brendan779/ipad-pro-wall-mount/flush-v5.1/CUTOUT_TEMPLATE_A3.pdf

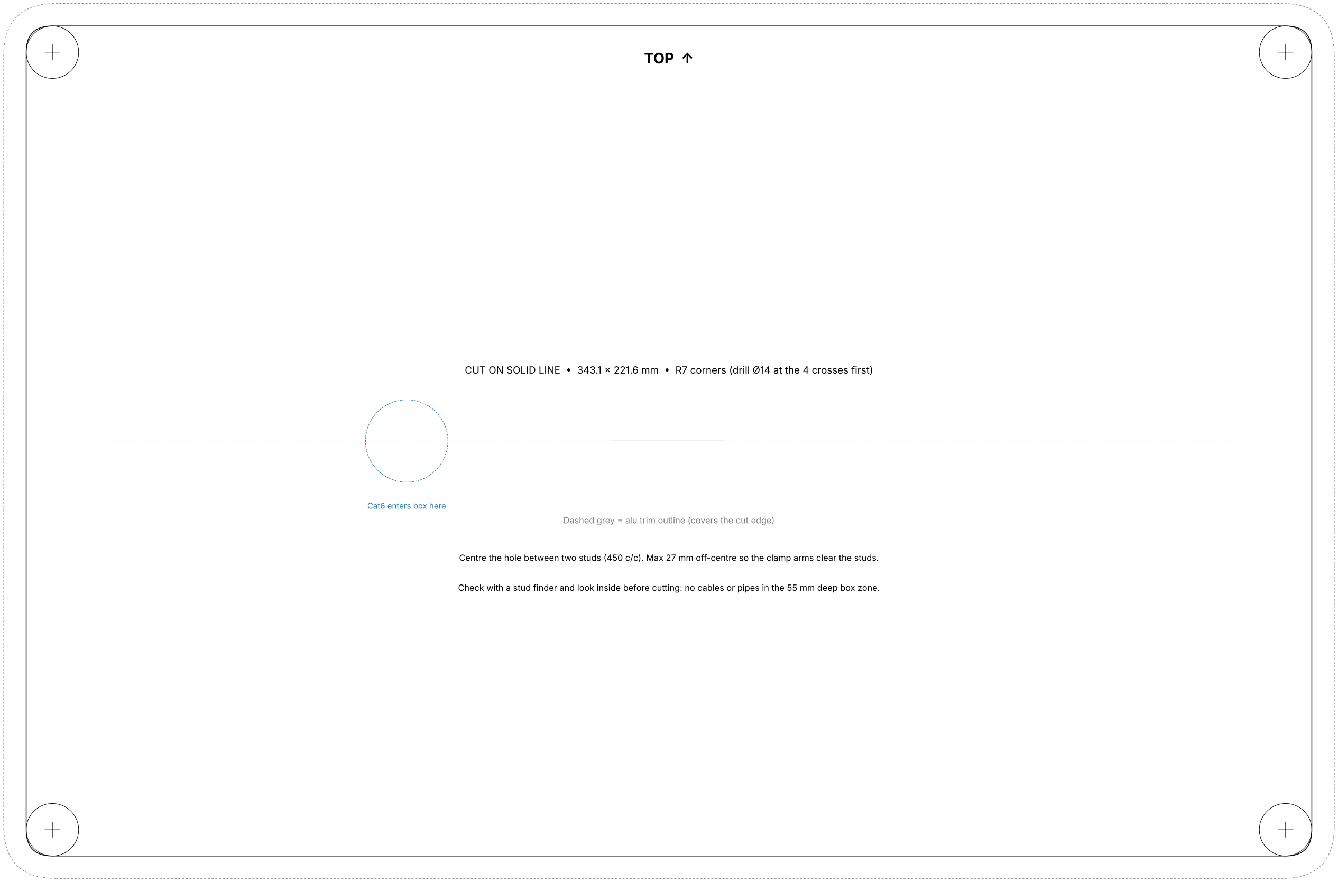
[picture p4: figure]
Cat6 enters box here; TOP ↑

CUT ON SOLID LINE • 343.1 × 221.6 mm • R7 corners (drill Ø14 at the 4 crosses first)

Dashed grey = alu trim outline (covers the cut edge)

Centre the hole between two studs (450 c/c). Max 27 mm off-centre so the clamp arms clear the studs.

Check with a stud finder and look inside before cutting: no cables or pipes in the 55 mm deep box zone.

Print at 100% / Actual size on A3. This bar must measure exactly 100 mm.

iPad Pro 12.9 Flush Mount v5 • plasterboard cut-out template
