brendan779/ipad-pro-wall-mount/ipad_mini_a17_pro/flush/machined/CUTOUT_TEMPLATE_A3.pdf

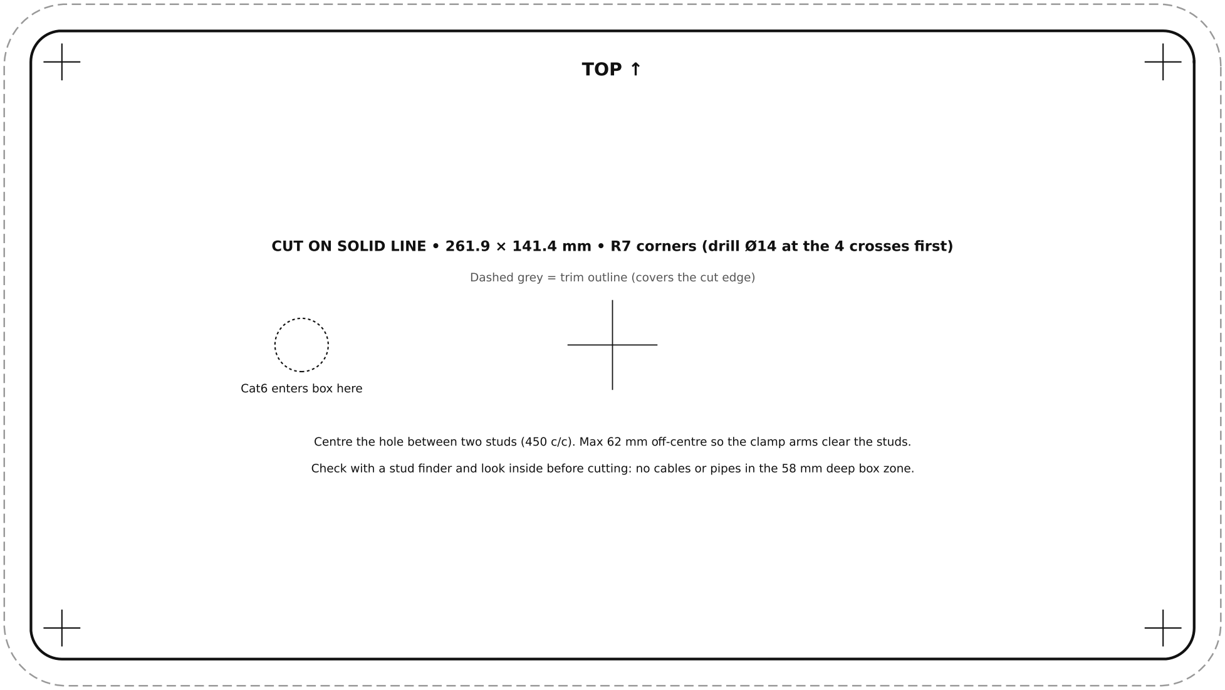
[picture p5: figure]
Cat6 enters box here; TOP ↑

## CUT ON SOLID LINE • 261.9 × 141.4 mm • R7 corners (drill Ø14 at the 4 crosses first)

Dashed grey = trim outline (covers the cut edge)

Centre the hole between two studs (450 c/c). Max 62 mm off-centre so the clamp arms clear the studs.

Check with a stud finder and look inside before cutting: no cables or pipes in the 58 mm deep box zone.

## iPad mini (A17 Pro) Flush Mount v6 • plasterboard cut-out template

Print at 100% / Actual size on A3. This bar must measure exactly 100 mm.
