brendan779/ipad-pro-wall-mount/ipad_pro_11_m5/flush/machined/CUTOUT_TEMPLATE_A3.pdf

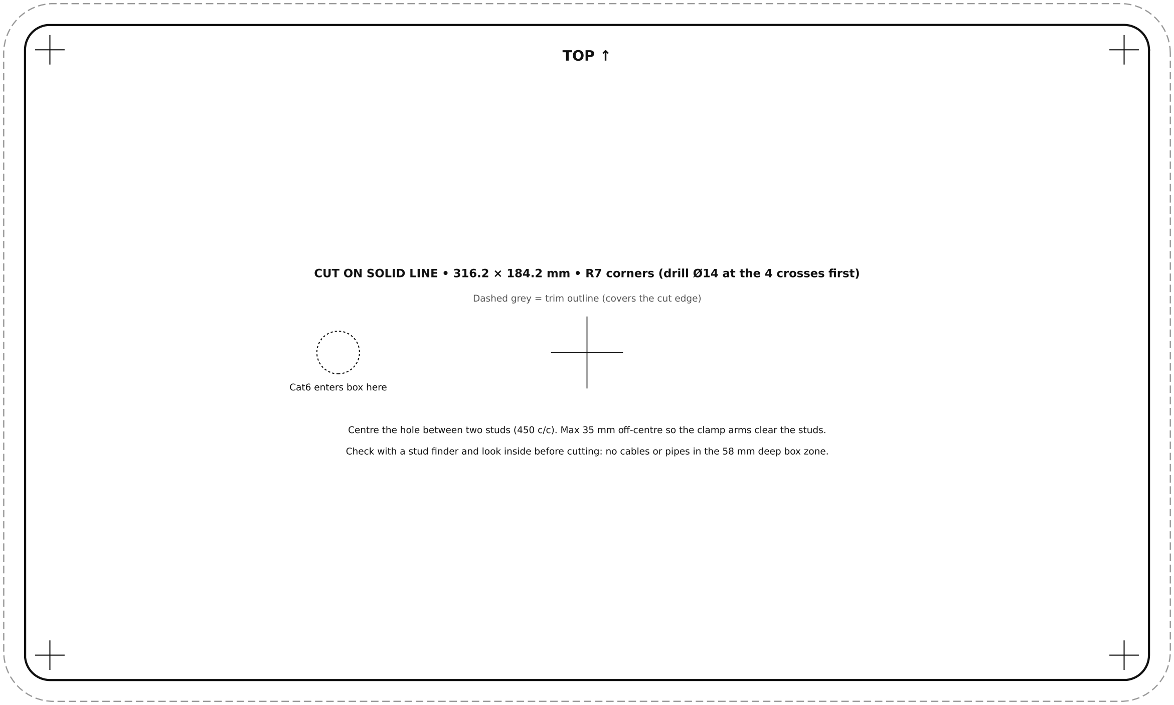
[picture p6: figure]
Cat6 enters box here; TOP ↑

# CUT ON SOLID LINE • 316.2 × 184.2 mm • R7 corners (drill Ø14 at the 4 crosses first)

Dashed grey = trim outline (covers the cut edge)

Centre the hole between two studs (450 c/c). Max 35 mm off-centre so the clamp arms clear the studs.

Check with a stud finder and look inside before cutting: no cables or pipes in the 58 mm deep box zone.

# iPad Pro 11″ (M5) Flush Mount v6 • plasterboard cut-out template

Print at 100% / Actual size on A3. This bar must measure exactly 100 mm.
