brendan779/ipad-pro-wall-mount/previous-releases/README.md

# Previous releases: Float v4.1 / v4.2, Flush v5.1

> **These versions are superseded by [v6](../)**, which builds both mounts for the iPad Pro 12.9″ (3rd gen), iPad Pro 13″ and 11″ (M5) and iPad mini (A17 Pro). v6 fixes the 12.9″'s pressed volume buttons, adds 2 mm more room at each end for the USB-C cable loop, adds end stops to the Float's wall rail, and models every piece of hardware in the STEP files. Start a new build from [the v6 README](../README.md).
>
> Everything below is kept unchanged for reference and for panels already built.

A premium wall mount that turns an **iPad Pro 12.9″ (3rd gen: A1876, A1895, A2014, A1983)** into a permanently powered HomeKit / Home Assistant panel over a single Cat6 cable (PoE+). It has a machined 6061 aluminium face and 3D-printed hidden parts, with the cable fully concealed.

There are two versions:

| | [**Float v4.1**](float-v4.1/) (surface mount) | [**Flush v5.1**](flush-v5.1/) (in-wall) |
|---|---|---|
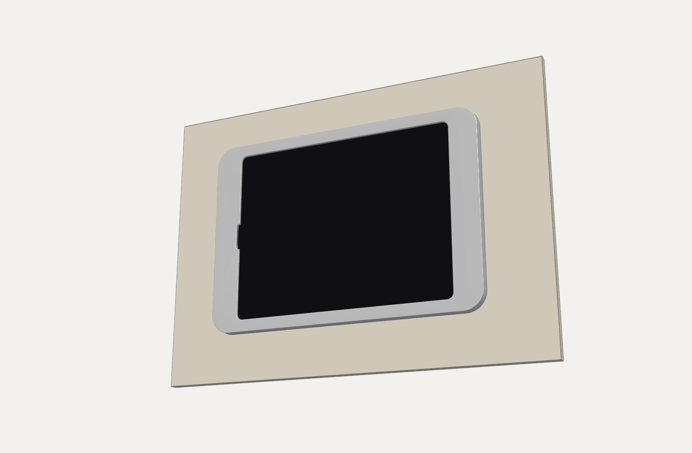
[picture p7: previous-releases/float-v4.1/images/hero.png]
Float v4.1
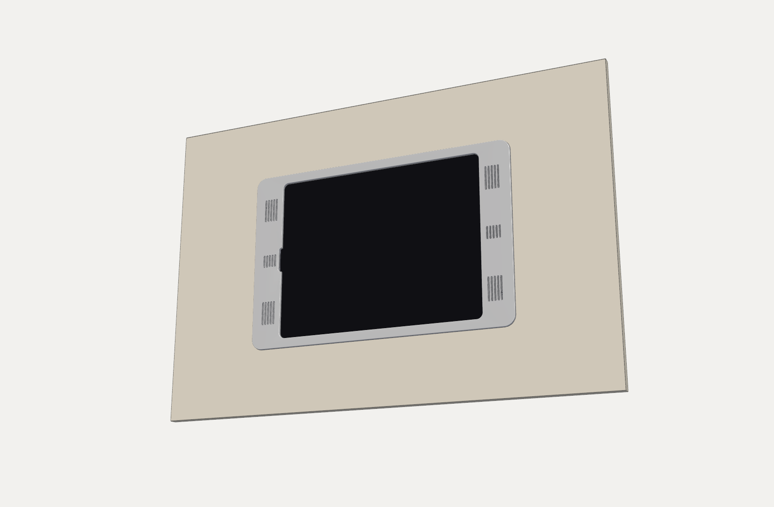
[picture p8: previous-releases/flush-v5.1/images/hero.png]
Flush v5.1
| |  |  |
| Look | Floats 14 mm off the wall on a shadow gap | Glass 1.2 mm off the wall, trim 4.5 mm proud |
| Aluminium part | 344.1 × 238.9 × 11.7 mm shell, about 223 g | 355.1 × 233.6 × 3 mm trim, about 188 g |
| Wall work | One small cut-out behind the panel for the cable | 343.1 × 221.6 mm cut-out between studs (10 mm plasterboard, 70 mm studs at 450 c/c) |
| Fixing | Bracket + hook + one hidden M3 lock screw | 4 dog-ear arms clamp the plasterboard; magnetic trim |
| Build manual (PDF) | [Float_Mount_v4.1_Build_Manual.pdf](float-v4.1/Float_Mount_v4.1_Build_Manual.pdf) | [Float_Mount_v5.1_Flush_Build_Manual.pdf](flush-v5.1/Float_Mount_v5.1_Flush_Build_Manual.pdf) |
| Build manual (web) | [BUILD_MANUAL.md](float-v4.1/BUILD_MANUAL.md) | [BUILD_MANUAL.md](flush-v5.1/BUILD_MANUAL.md) |

**Ordering the Float shell from a CNC service?** Use [**Float v4.2**](float-v4.2/) and its [build manual](float-v4.2/Float_Mount_v4.2_Build_Manual.pdf). It is v4.1 plus a JLCCNC-ready manufacturing drawing (threaded holes M3/M2.5, hole table, section), drill-point-safe hole depths with M3 × 5 / M2.5 × 5 screws, and one-piece versions of the split printed parts for large-bed printers.

**No CNC?** Both mounts also come in a [**fully printed**](fully-printed/) version. The aluminium face becomes a two-piece printed face joined with dovetails, and each version has a ready-to-slice Bambu Studio 3MF (also suitable for MakerWorld).

Both versions use a **standard straight USB-C cable** (the plug and its bend hide inside the frame ends), a PoE+ to USB-C adapter (e.g. PoE Texas / Heckler T515), and print with **no supports** on a 256 mm bed (Bambu P1S / X1C class) in PETG or ASA.

## Repository layout

```
float-v4.1/                 surface-mount version
  README.md                 build notes: parts, machining, hardware, assembly
  Float_Mount_v4.1_Build_Manual.pdf  build manual, one step per page
  BUILD_MANUAL.md           the same manual as a GitHub page
  hybrid.py                 parametric CadQuery source (regenerates every file)
  overhang_audit.py         checks each part for unsupported overhangs
  assembly_hybrid_v4_1.step whole stack
  machine/shell_6061.step   the aluminium part, for CAM
  print/                    STL + STEP for every printed part
  images/                   manual renders and schematics

float-v4.2/                 v4.1 + CNC drawing for the shell, drill-safe threads, one-piece printed parts
  Float_Mount_v4.2_Build_Manual.pdf  build manual (v4.2 changes, JLCCNC ordering, printed-shell option)
  machine/shell_6061_drawing.pdf   A3 drawing to send with shell_6061.step
  print/one_piece/          uncut carrier (340 mm beds)

flush-v5.1/                 flush in-wall version
  README.md, Float_Mount_v5.1_Flush_Build_Manual.pdf, BUILD_MANUAL.md, flush51.py
  CUTOUT_TEMPLATE_A3.pdf    print at 100% on A3 (100 mm check bar)
  assembly_flush_v5_1.step, machine/trim_6061.step, print/, images/

fully-printed/              no-machining versions: printed face halves + Bambu Studio 3MF projects
  float-v4.1-printed/       Float_Mount_v4.1_Printed.3mf, print/
  float-v4.2-printed/       Float_Mount_v4.2_Printed.3mf, print/, print/one_piece/ (uncut shell + carrier)
  flush-v5.1-printed/       Float_Mount_v5.1_Flush_Printed.3mf, print/
  printed.py, printed42.py, make3mf.py   regenerate the printed faces and the 3MFs

../tools/manual/            scripts that render the manual images (VTK + matplotlib)
```

## Customising

Every dimension comes from the parameters at the top of `hybrid.py` / `flush51.py`. Measure your USB-C plug (`PLUG_L`, `PLUG_W`, `PLUG_H`), cable (`CABLE_D`, `BEND_R`) or wall (`PLASTER`), change the numbers and re-run:

```bash
pip install cadquery
cd float-v4.1 && python hybrid.py out      # writes print/, machine/ and STEP files to ./out
cd flush-v5.1 && python flush51.py out
```

To regenerate the manual images: `cd ../tools/manual && python render_v41.py && python render_v51.py && python schematics.py && python sections.py` (needs `vtk`, `matplotlib`). Run `sections.py` last; it draws the final cross-sections.

## Notes

- Button, camera, speaker and microphone positions on the iPad are close approximations. Print a test fit (v4.1 includes a printable copy of the aluminium shell) before you machine metal or cut a wall.
- The physical buttons end up covered. Use AssistiveTouch, Siri or Settings › Shut Down.
- The build manuals follow the style of the free [Flightory](https://flightory.com) RC plane manuals.

## Licence

[GPL-3.0](../LICENSE)
