brendan779/ipad-pro-wall-mount/float-v4.2/images/mach_bosses.png

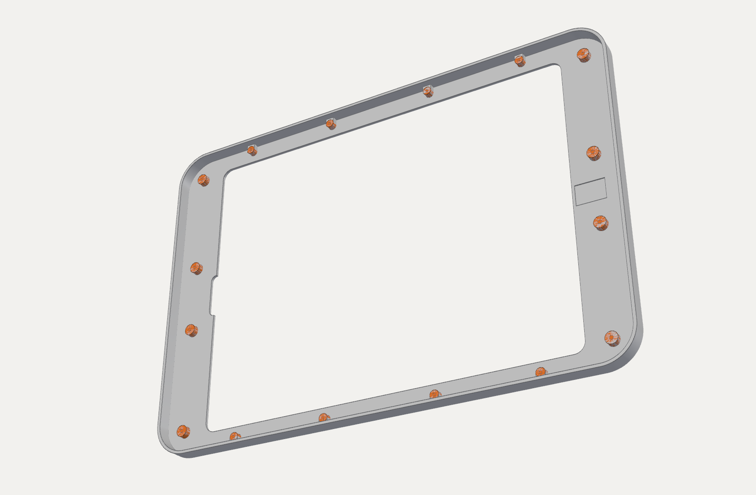
float-v4.2/images/mach_bosses.png
