brendan779/ipad-pro-wall-mount/float-v4.2/images/w4_hang.png

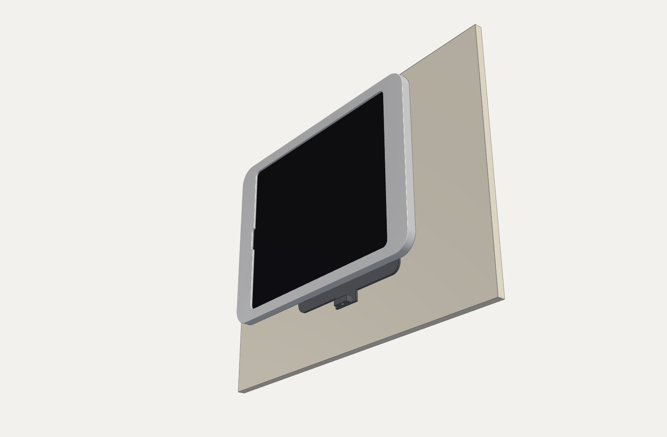
float-v4.2/images/w4_hang.png
