brendan779/ipad-pro-wall-mount/ipad_mini_a17_pro/float/machined/machine/shell_6061_drawing.png

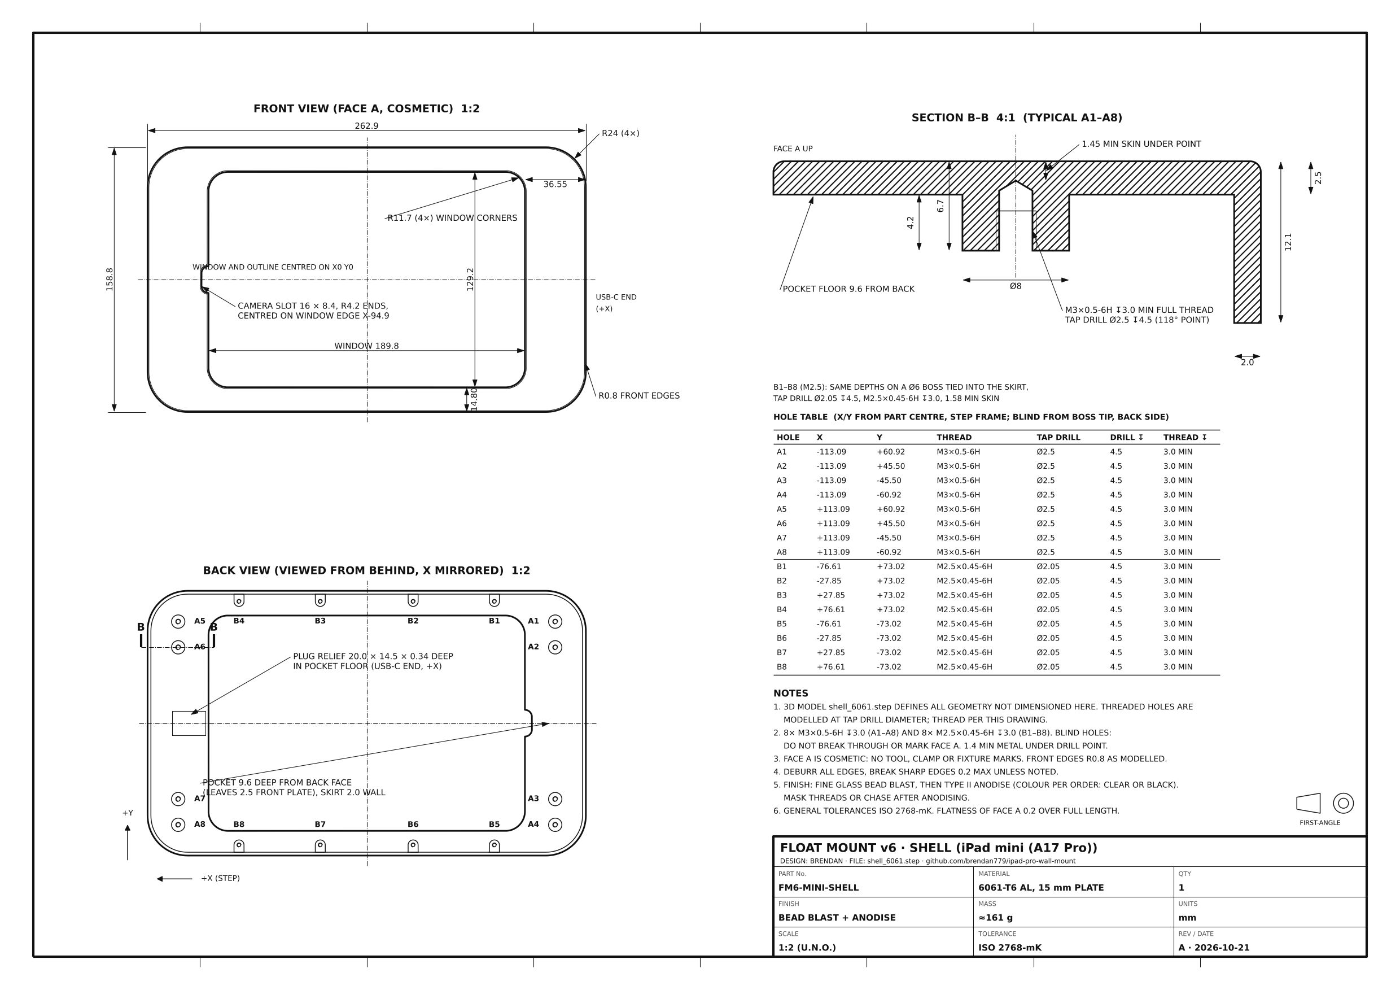
ipad_mini_a17_pro/float/machined/machine/shell_6061_drawing.png
