brendan779/ipad-pro-wall-mount/ipad_pro_13_m5/float/machined/machine/shell_6061_drawing.png

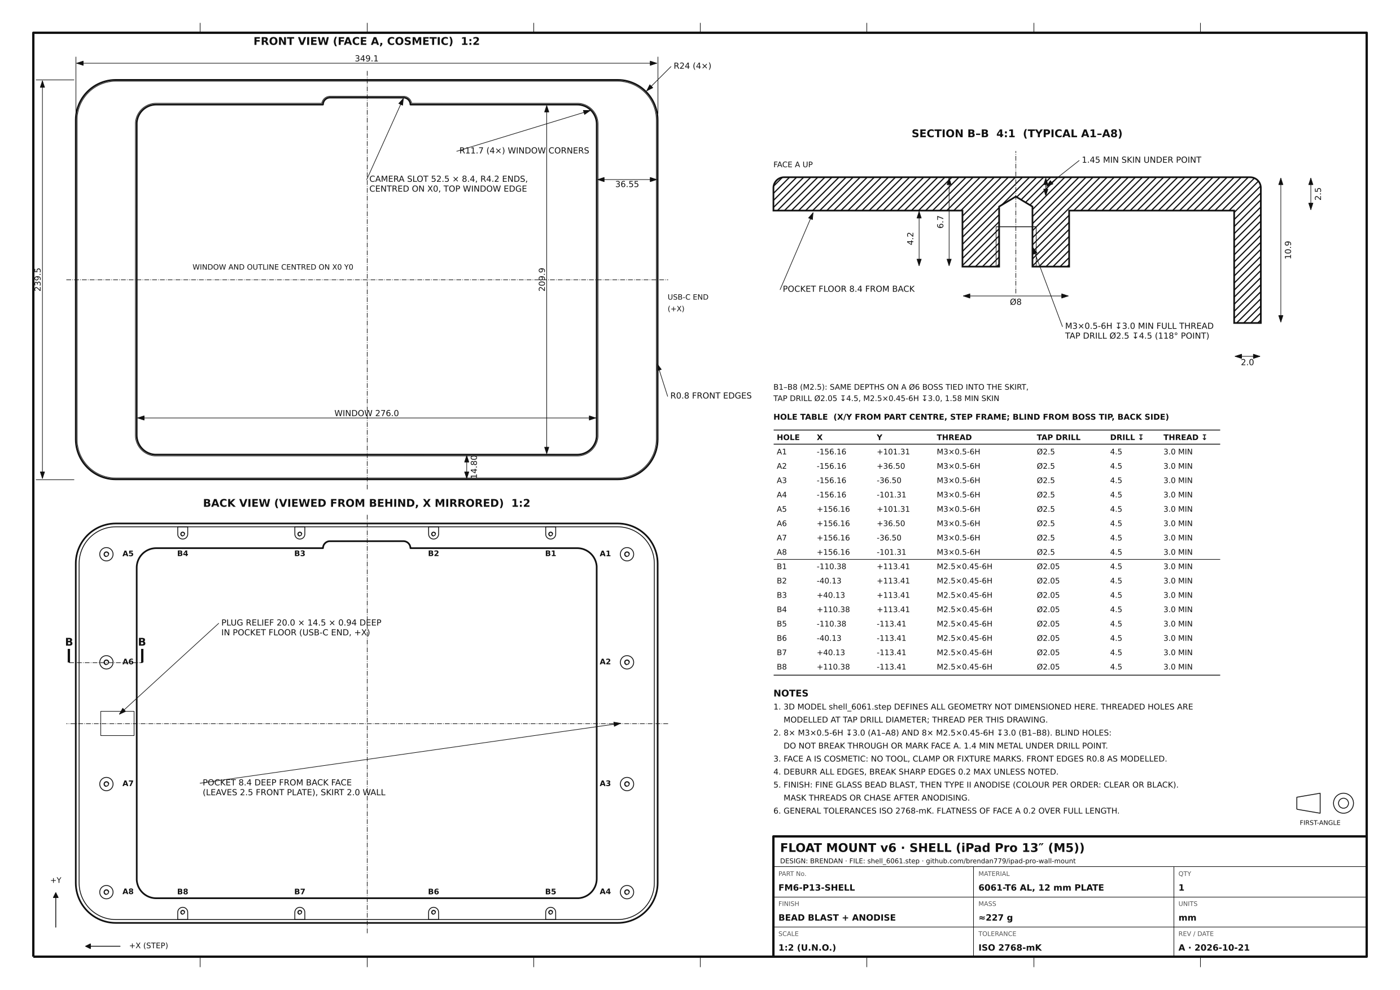
ipad_pro_13_m5/float/machined/machine/shell_6061_drawing.png
