brendan779/ipad-pro-wall-mount/float-v4.2/assembly_hybrid_v4_2.step

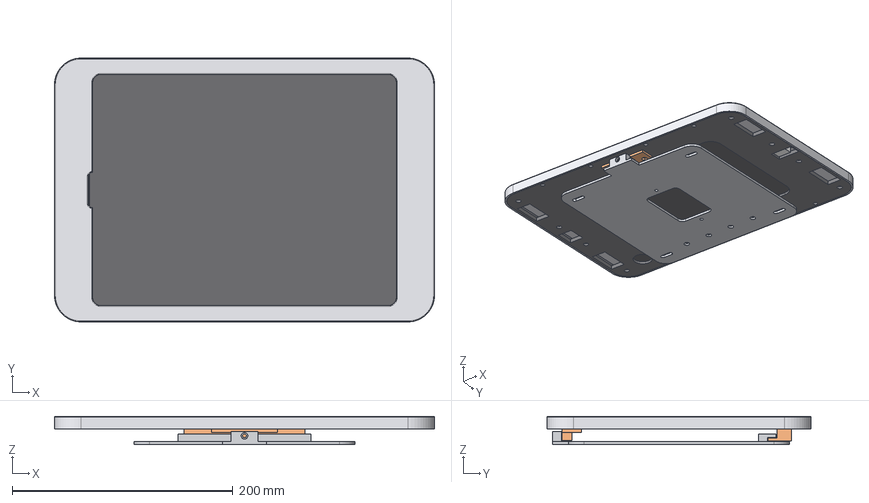
[picture p14: CAD file, 2026-10-20]
float-v4.2/assembly_hybrid_v4_2.step
344.1 x 238.9 x 25.7 mm
wall_bracket
carrier
hanger
lock_boss
ipad_reference
usb_c_plug_reference
