brendan779/ipad-pro-wall-mount/flush-v5.1/assembly_flush_v5_1.step

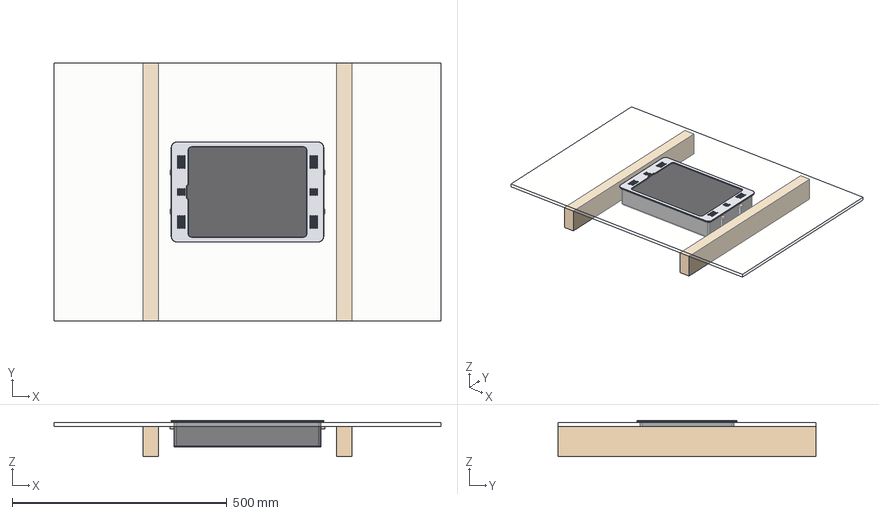
[picture p15: CAD file, 2026-10-19]
flush-v5.1/assembly_flush_v5_1.step
900.0 x 600.0 x 84.5 mm
studs_reference
plasterboard_reference
sleeve
deck
back_plate
dog_ear_1
dog_ear_2
dog_ear_3
dog_ear_4
ipad_reference
usb_c_plug_reference
trim_6061
