brendan779/ipad-pro-wall-mount/ipad_mini_a17_pro/float/machined/assembly_float6.step

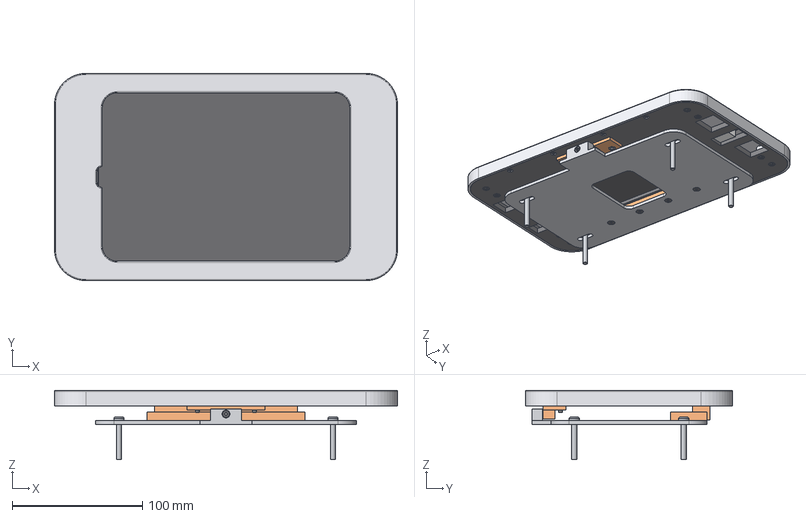
[picture p16: CAD file, 2026-10-21]
ipad_mini_a17_pro/float/machined/assembly_float6.step
262.9 x 158.8 x 53.1 mm
wall_bracket
catch_rail
carrier
hanger
lock_boss
ipad_reference
usb_c_plug_reference
hw_M3x5_cap_ISO4762_1 x 8
hw_M2.5x5_cap_ISO4762_1 x 8
hw_M3_heat-set_insert_1 x 9
hw_M3x8_countersunk_ISO10642_1 x 10
hw_M3_nut_ISO4032_1
hw_M3_nut_ISO4032_2
hw_M3x12_cap_ISO4762_1
hw_wall_screw_M4x30_pan_reference_1 x 4
