brendan779/ipad-pro-wall-mount/ipad_mini_a17_pro/float/machined/print/one_piece/carrier_full.step

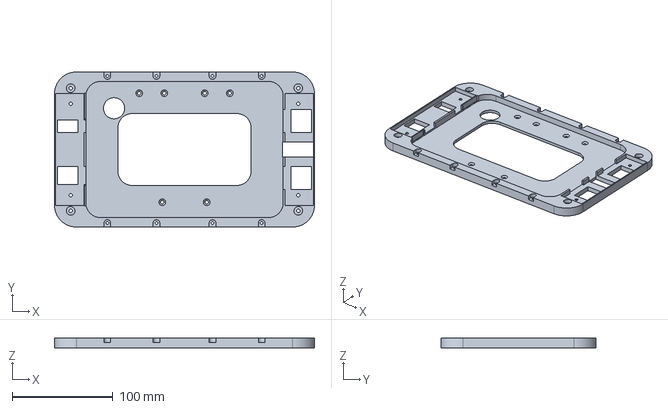
[picture p17: CAD file, 2026-10-20]
ipad_mini_a17_pro/float/machined/print/one_piece/carrier_full.step
258.3 x 154.2 x 9.62 mm
