brendan779/ipad-pro-wall-mount/ipad_mini_a17_pro/float/printed/print/one_piece/shell_print_full.step

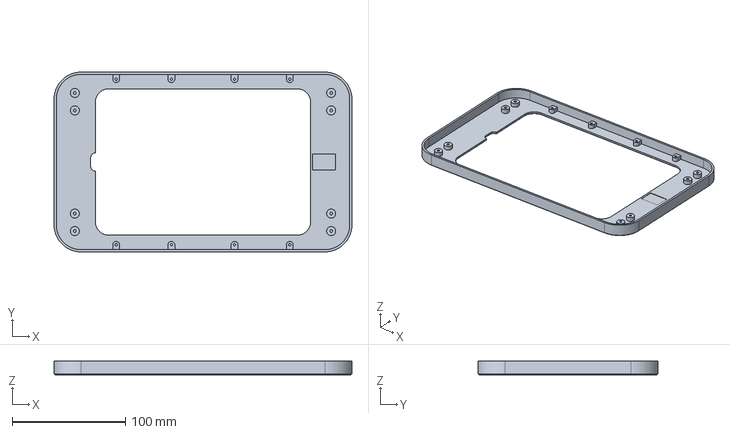
[picture p18: CAD file, 2026-10-20]
ipad_mini_a17_pro/float/printed/print/one_piece/shell_print_full.step
262.9 x 158.8 x 12.1 mm
