brendan779/ipad-pro-wall-mount/ipad_mini_a17_pro/flush/machined/assembly_flush6.step

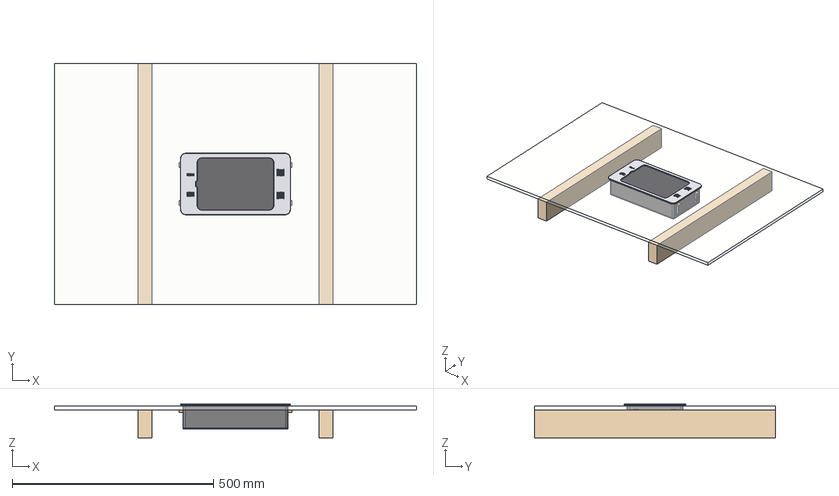
[picture p19: CAD file, 2026-10-20]
ipad_mini_a17_pro/flush/machined/assembly_flush6.step
900.0 x 600.0 x 84.5 mm
studs_reference
plasterboard_reference
sleeve
deck
back_plate
dog_ear_1
dog_ear_2
dog_ear_3
dog_ear_4
ipad_reference
usb_c_plug_reference
trim_6061
hw_magnet_N52_10x1.5_1
hw_magnet_N52_10x1.5_2
hw_magnet_N52_10x1.5_3
hw_magnet_N52_10x1.5_4
hw_magnet_N52_10x1.5_5
hw_magnet_N52_10x1.5_6
hw_magnet_N52_10x1.5_7
hw_magnet_N52_10x1.5_8
hw_dowel_pin_3x6_ISO8734_1
hw_dowel_pin_3x6_ISO8734_2
hw_M4x30_pan_ISO7045_1 x 4
hw_M4_heat-set_insert_1 x 4
hw_M3_heat-set_insert_1 x 8
hw_M3x8_countersunk_ISO10642_1 x 8
