brendan779/ipad-pro-wall-mount/ipad_mini_a17_pro/flush/machined/print/one_piece/sleeve_full.step

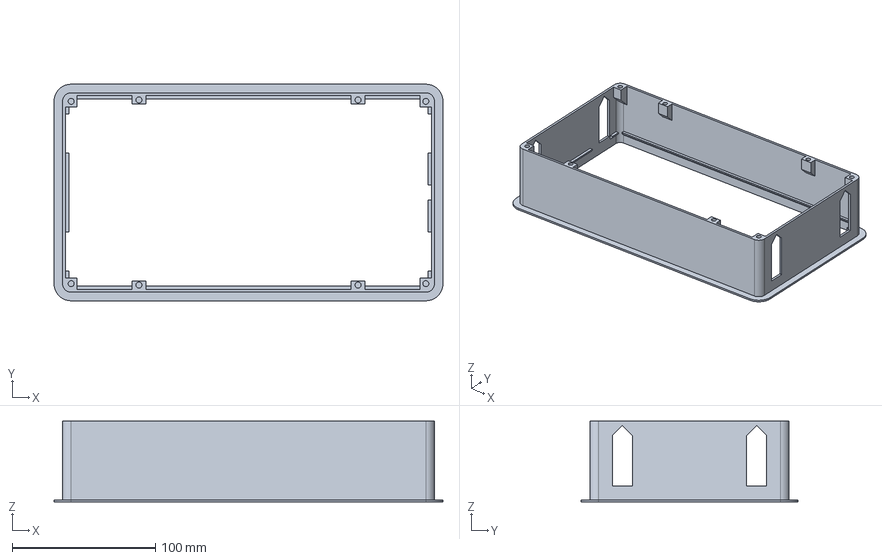
[picture p20: CAD file, 2026-10-20]
ipad_mini_a17_pro/flush/machined/print/one_piece/sleeve_full.step
271.9 x 151.4 x 56.5 mm
