brendan779/ipad-pro-wall-mount/ipad_mini_a17_pro/flush/printed/print/one_piece/trim_print_full.step

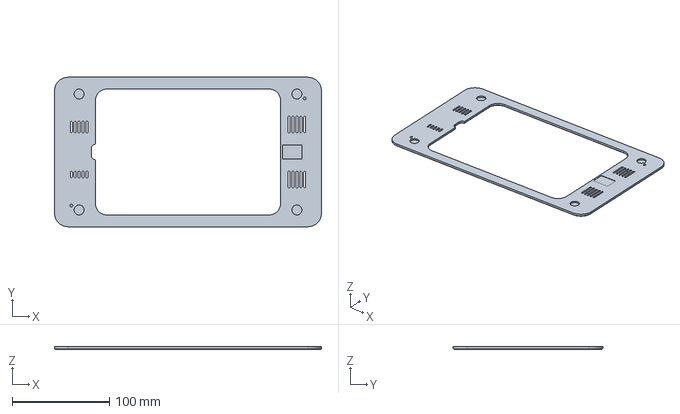
[picture p21: CAD file, 2026-10-20]
ipad_mini_a17_pro/flush/printed/print/one_piece/trim_print_full.step
273.9 x 153.4 x 3.00 mm
