brendan779/ipad-pro-wall-mount/ipad_pro_11_m5/float/machined/print/one_piece/carrier_full.step

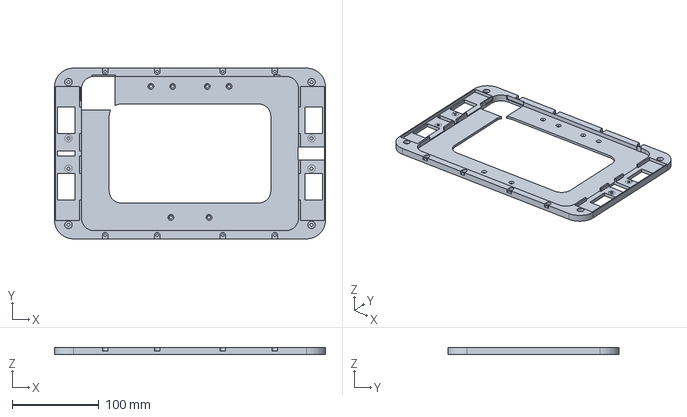
[picture p23: CAD file, 2026-10-20]
ipad_pro_11_m5/float/machined/print/one_piece/carrier_full.step
312.6 x 196.9 x 8.59 mm
