brendan779/ipad-pro-wall-mount/ipad_pro_11_m5/float/printed/print/one_piece/shell_print_full.step

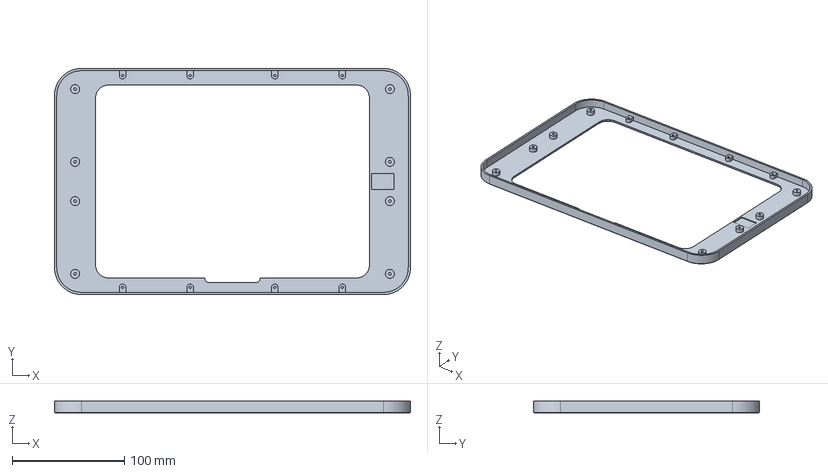
[picture p24: CAD file, 2026-10-20]
ipad_pro_11_m5/float/printed/print/one_piece/shell_print_full.step
317.2 x 201.5 x 11.1 mm
