brendan779/ipad-pro-wall-mount/ipad_pro_11_m5/flush/machined/print/one_piece/back_plate_full.step

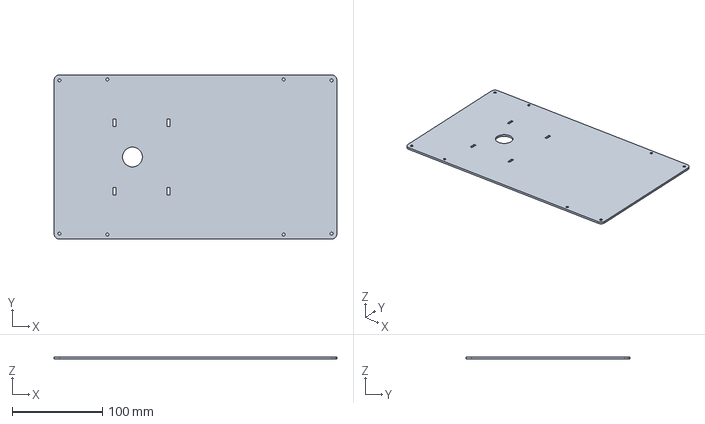
[picture p26: CAD file, 2026-10-20]
ipad_pro_11_m5/flush/machined/print/one_piece/back_plate_full.step
314.2 x 182.2 x 2.50 mm
