brendan779/ipad-pro-wall-mount/ipad_pro_11_m5/flush/printed/print/one_piece/deck_full.stl

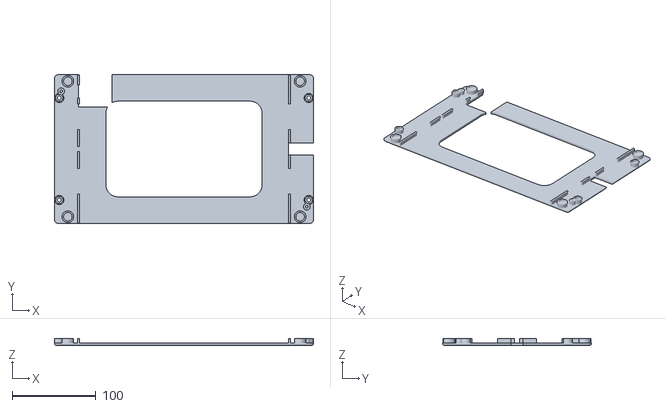
[picture p27: CAD file, 2026-10-20]
ipad_pro_11_m5/flush/printed/print/one_piece/deck_full.stl
309.6 x 177.6 x 8.59
