brendan779/ipad-pro-wall-mount/ipad_pro_12_9_gen3/float/machined/assembly_float6.step

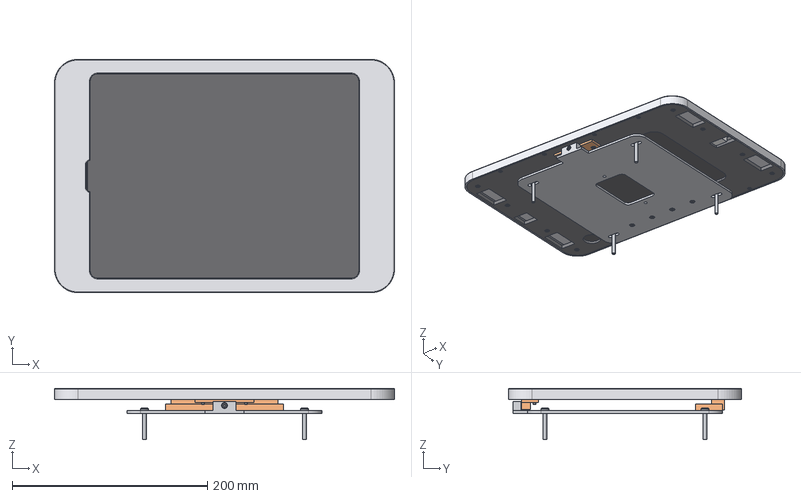
[picture p28: CAD file, 2026-10-21]
ipad_pro_12_9_gen3/float/machined/assembly_float6.step
348.1 x 238.9 x 52.7 mm
wall_bracket
catch_rail
carrier
hanger
lock_boss
ipad_reference
usb_c_plug_reference
hw_M3x5_cap_ISO4762_1 x 8
hw_M2.5x5_cap_ISO4762_1 x 8
hw_M3_heat-set_insert_1 x 9
hw_M3x8_countersunk_ISO10642_1 x 10
hw_M3_nut_ISO4032_1
hw_M3_nut_ISO4032_2
hw_M3x12_cap_ISO4762_1
hw_wall_screw_M4x30_pan_reference_1 x 4
