brendan779/ipad-pro-wall-mount/ipad_pro_12_9_gen3/float/machined/print/one_piece/carrier_full.step

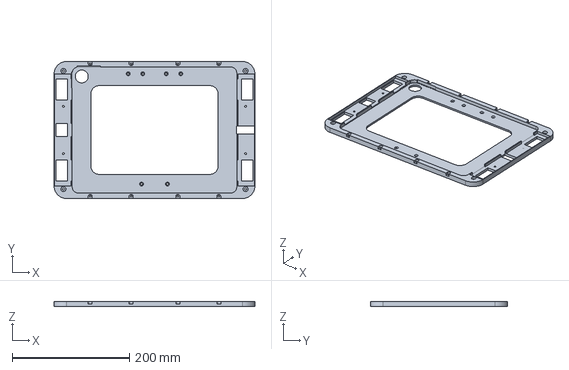
[picture p29: CAD file, 2026-10-20]
ipad_pro_12_9_gen3/float/machined/print/one_piece/carrier_full.step
343.5 x 234.3 x 9.20 mm
