brendan779/ipad-pro-wall-mount/ipad_pro_12_9_gen3/float/printed/print/one_piece/shell_print_full.step

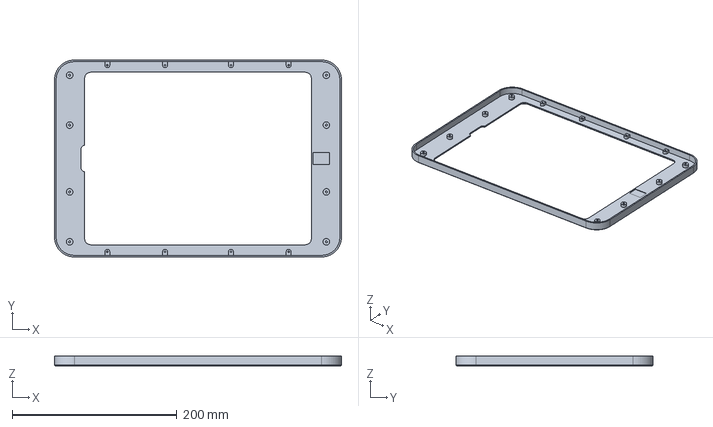
[picture p30: CAD file, 2026-10-20]
ipad_pro_12_9_gen3/float/printed/print/one_piece/shell_print_full.step
348.1 x 238.9 x 11.7 mm
