brendan779/ipad-pro-wall-mount/ipad_pro_12_9_gen3/flush/machined/print/one_piece/deck_full.step

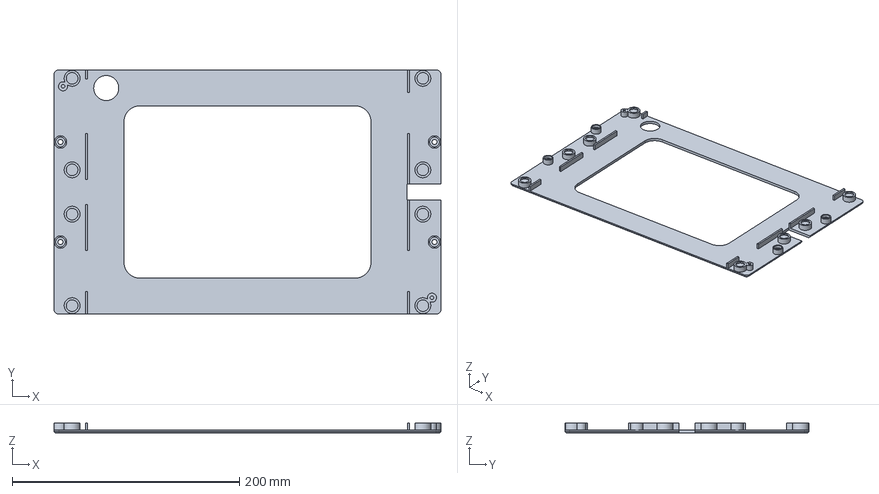
[picture p31: CAD file, 2026-10-20]
ipad_pro_12_9_gen3/flush/machined/print/one_piece/deck_full.step
340.5 x 215.0 x 9.20 mm
