brendan779/ipad-pro-wall-mount/ipad_pro_12_9_gen3/flush/printed/print/one_piece/trim_print_full.step

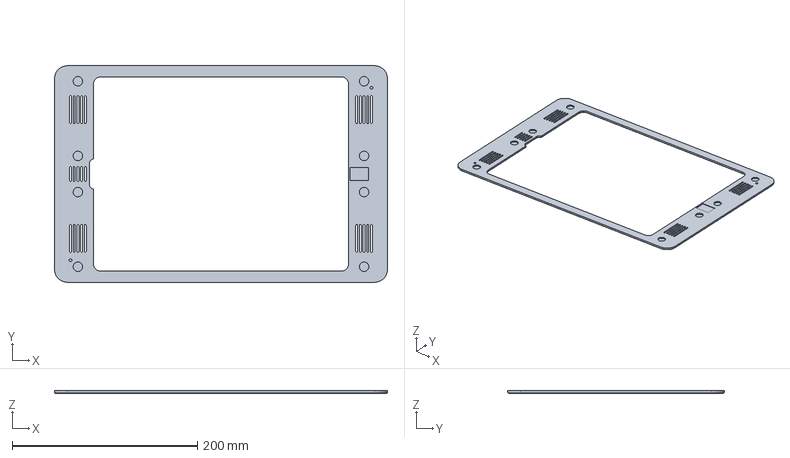
[picture p32: CAD file, 2026-10-20]
ipad_pro_12_9_gen3/flush/printed/print/one_piece/trim_print_full.step
359.1 x 233.6 x 3.00 mm
