brendan779/ipad-pro-wall-mount/ipad_pro_13_m5/float/machined/print/one_piece/carrier_full.step

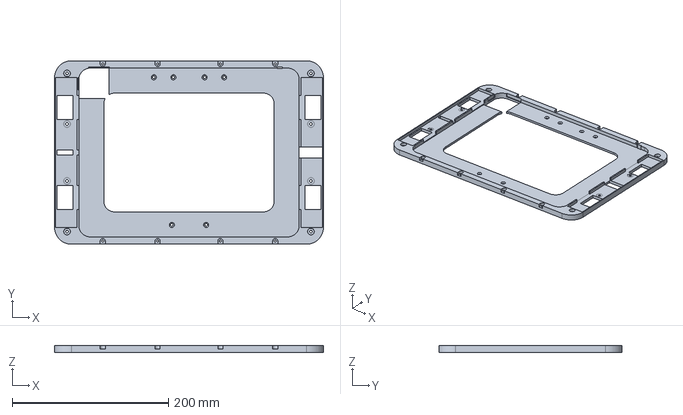
[picture p34: CAD file, 2026-10-20]
ipad_pro_13_m5/float/machined/print/one_piece/carrier_full.step
344.5 x 234.9 x 8.43 mm
