brendan779/ipad-pro-wall-mount/ipad_pro_13_m5/flush/machined/print/one_piece/deck_full.step

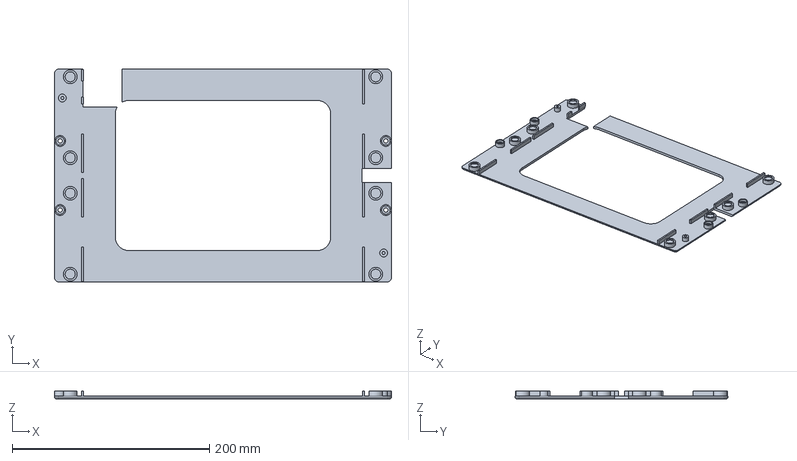
[picture p35: CAD file, 2026-10-20]
ipad_pro_13_m5/flush/machined/print/one_piece/deck_full.step
341.5 x 215.6 x 8.43 mm
