brendan779/ipad-pro-wall-mount/ipad_pro_13_m5/flush/printed/print/one_piece/trim_print_full.step

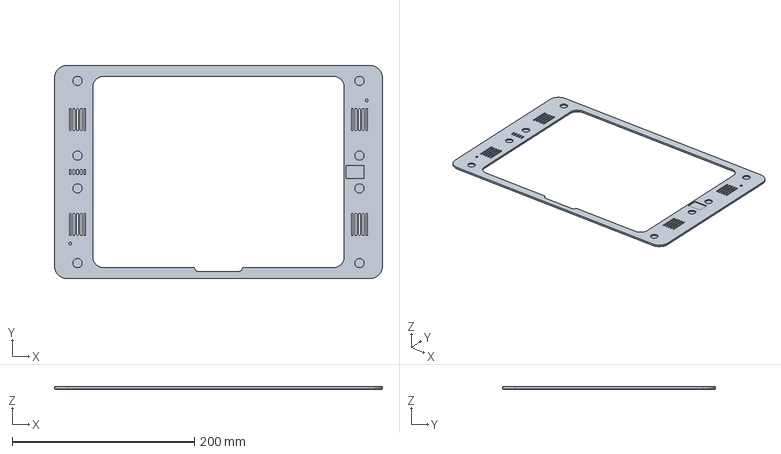
[picture p36: CAD file, 2026-10-20]
ipad_pro_13_m5/flush/printed/print/one_piece/trim_print_full.step
360.1 x 234.2 x 3.00 mm
