brendan779/ipad-pro-wall-mount/ipad_mini_a17_pro/flush/machined/print/one_piece/back_plate_full.step

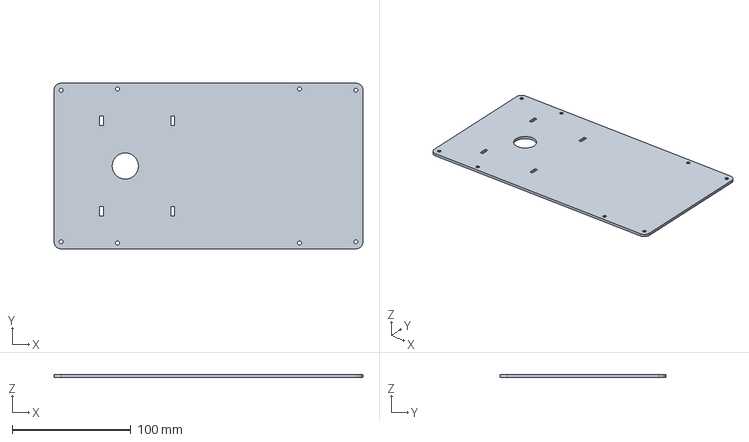
[picture p37: CAD file, 2026-10-20]
ipad_mini_a17_pro/flush/machined/print/one_piece/back_plate_full.step
259.9 x 139.4 x 2.50 mm
