brendan779/ipad-pro-wall-mount/ipad_mini_a17_pro/flush/printed/print/one_piece/deck_full.stl

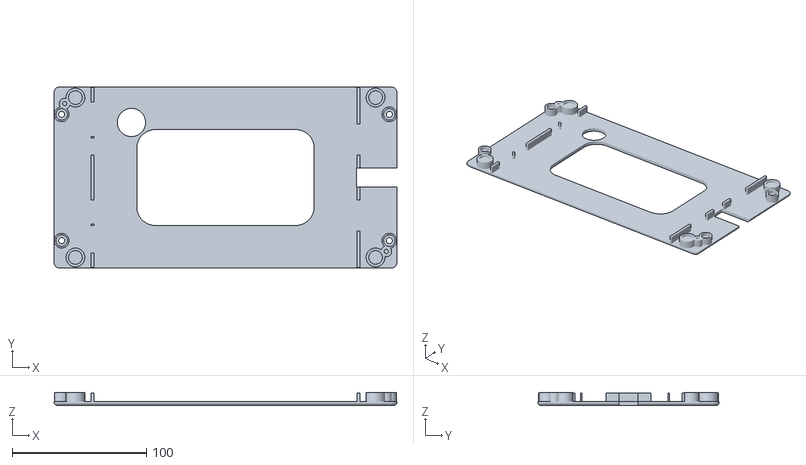
[picture p38: CAD file, 2026-10-20]
ipad_mini_a17_pro/flush/printed/print/one_piece/deck_full.stl
255.3 x 134.9 x 9.62
