brendan779/ipad-pro-wall-mount/ipad_pro_11_m5/flush/printed/print/one_piece/trim_print_full.step

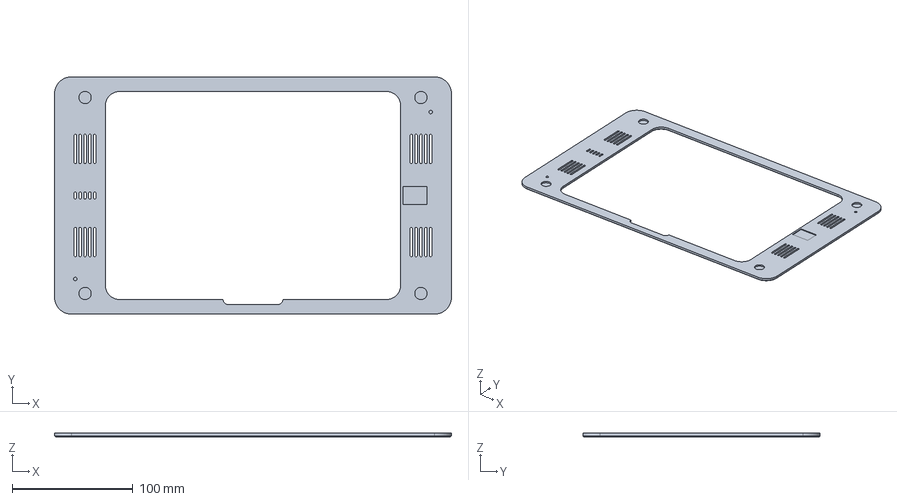
[picture p39: CAD file, 2026-10-20]
ipad_pro_11_m5/flush/printed/print/one_piece/trim_print_full.step
328.2 x 196.2 x 3.00 mm
