brendan779/ipad-pro-wall-mount/ipad_pro_12_9_gen3/flush/machined/print/one_piece/back_plate_full.step

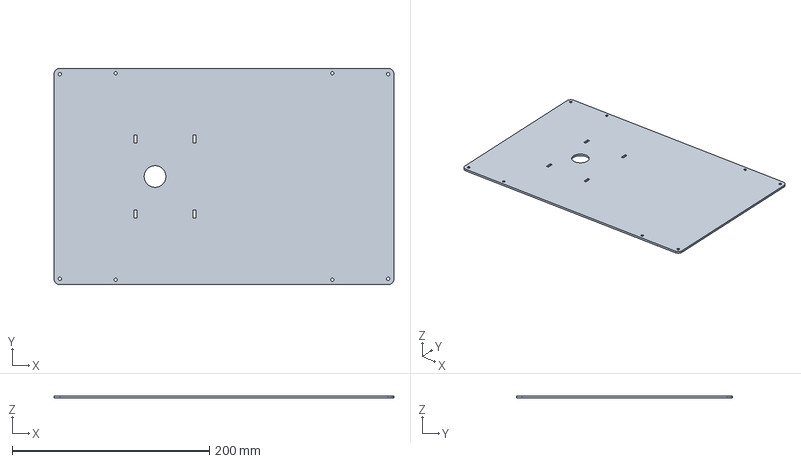
[picture p40: CAD file, 2026-10-20]
ipad_pro_12_9_gen3/flush/machined/print/one_piece/back_plate_full.step
345.1 x 219.6 x 2.50 mm
