brendan779/ipad-pro-wall-mount/ipad_pro_12_9_gen3/flush/printed/print/one_piece/sleeve_full.stl

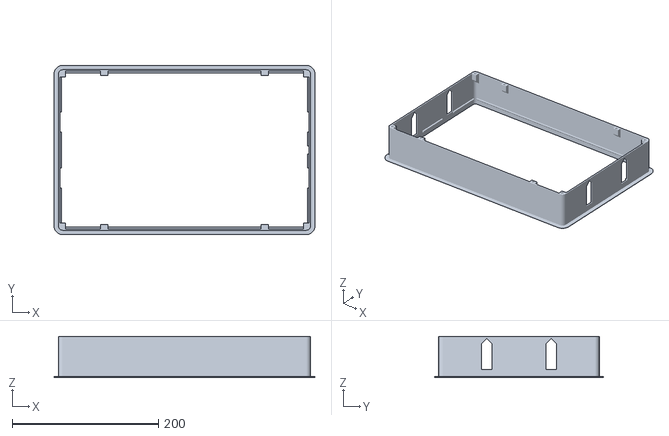
[picture p41: CAD file, 2026-10-20]
ipad_pro_12_9_gen3/flush/printed/print/one_piece/sleeve_full.stl
357.1 x 231.6 x 56.5
