brendan779/ipad-pro-wall-mount/ipad_pro_13_m5/float/printed/print/one_piece/shell_print_full.step

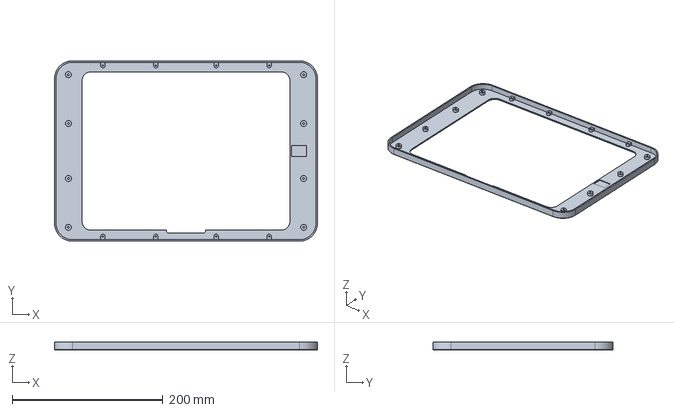
[picture p42: CAD file, 2026-10-20]
ipad_pro_13_m5/float/printed/print/one_piece/shell_print_full.step
349.1 x 239.5 x 10.9 mm
