brendan779/ipad-pro-wall-mount/ipad_pro_11_m5/flush/machined/print/one_piece/sleeve_full.step

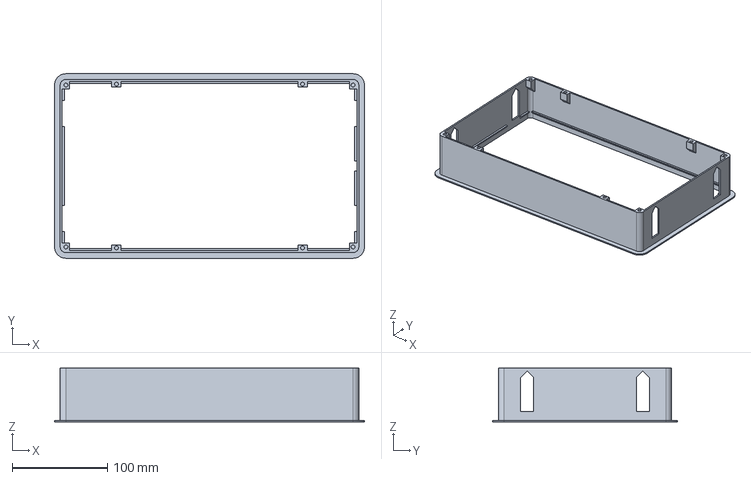
[picture p43: CAD file, 2026-10-20]
ipad_pro_11_m5/flush/machined/print/one_piece/sleeve_full.step
326.2 x 194.2 x 56.5 mm
