brendan779/ipad-pro-wall-mount/fully-printed/float-v4.2-printed/Float_Mount_v4.2_Printed.3mf

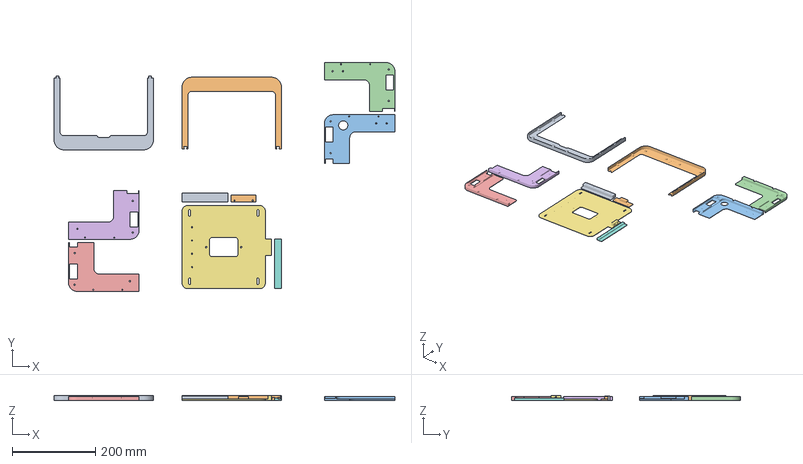
[picture p44: CAD file, 2026-10-20]
fully-printed/float-v4.2-printed/Float_Mount_v4.2_Printed.3mf
818.7 x 549.5 x 12.0 mm
shell_print_L
shell_print_R
carrier_TL
carrier_TR
carrier_BL
carrier_BR
wall_bracket
catch_rail
hanger
lock_boss
