brendan779/ipad-pro-wall-mount/fully-printed/flush-v5.1-printed/Float_Mount_v5.1_Flush_Printed.3mf

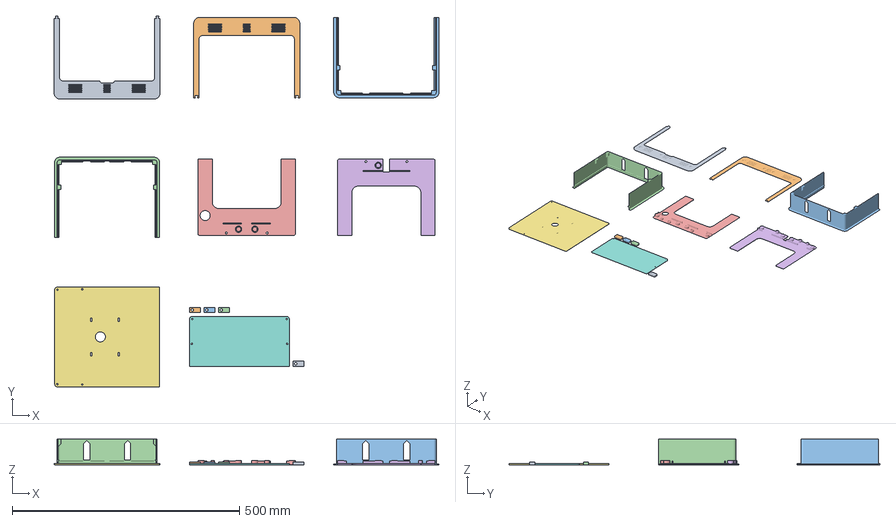
[picture p45: CAD file, 2026-10-19]
fully-printed/flush-v5.1-printed/Float_Mount_v5.1_Flush_Printed.3mf
847.0 x 815.5 x 56.5 mm
trim_print_L
trim_print_R
sleeve_L
sleeve_R
deck_L
deck_R
back_plate_L
back_plate_R
dog_ear_arm_1
dog_ear_arm_2
dog_ear_arm_3
dog_ear_arm_4
