brendan779/ipad-pro-wall-mount/ipad_mini_a17_pro/float/machined/print/hanger.step

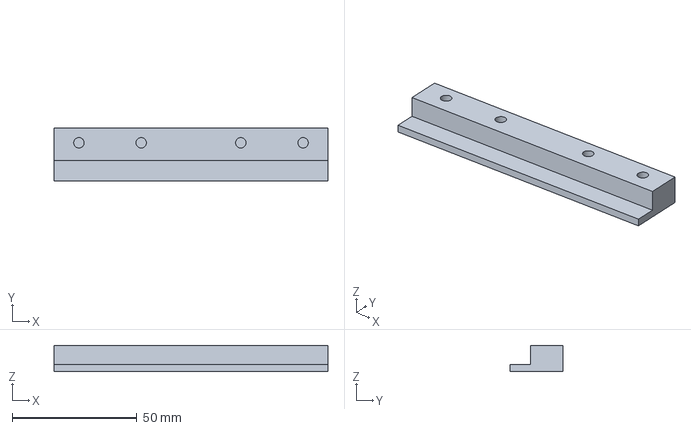
[picture p46: CAD file, 2026-10-20]
ipad_mini_a17_pro/float/machined/print/hanger.step
110.0 x 21.4 x 10.6 mm
