brendan779/ipad-pro-wall-mount/ipad_mini_a17_pro/float/printed/print/shell_print_R.step

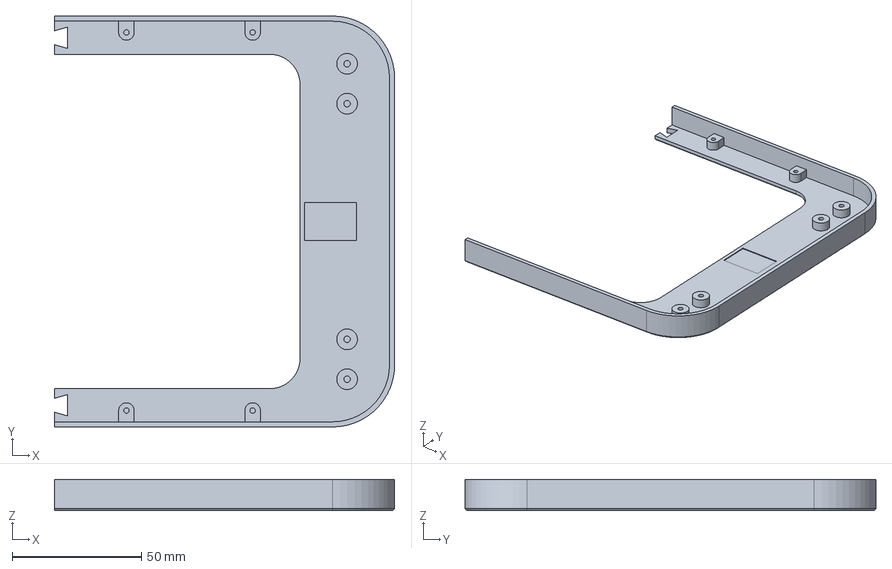
[picture p47: CAD file, 2026-10-20]
ipad_mini_a17_pro/float/printed/print/shell_print_R.step
131.5 x 158.8 x 12.1 mm
