brendan779/ipad-pro-wall-mount/ipad_mini_a17_pro/flush/machined/machine/trim_6061.step

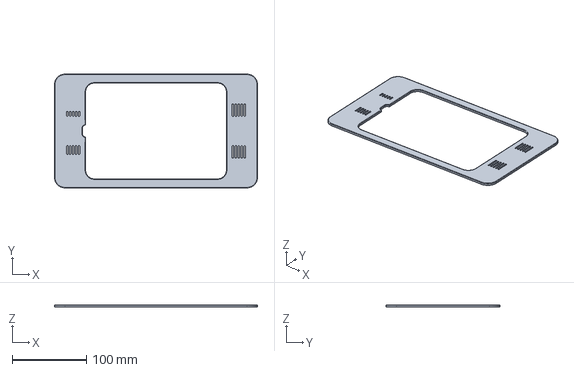
[picture p48: CAD file, 2026-10-20]
ipad_mini_a17_pro/flush/machined/machine/trim_6061.step
273.9 x 153.4 x 3.00 mm
