brendan779/ipad-pro-wall-mount/ipad_mini_a17_pro/flush/machined/print/back_plate_L.step

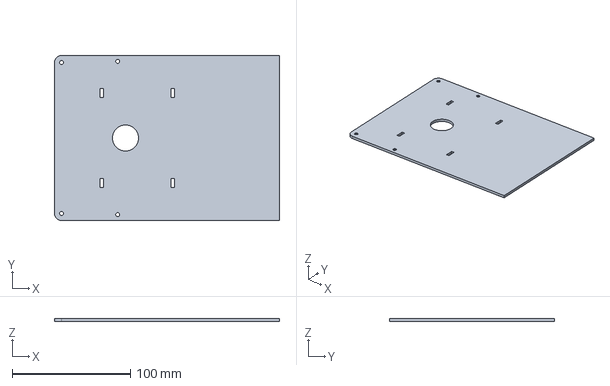
[picture p49: CAD file, 2026-10-20]
ipad_mini_a17_pro/flush/machined/print/back_plate_L.step
190.0 x 139.4 x 2.50 mm
