brendan779/ipad-pro-wall-mount/ipad_mini_a17_pro/flush/printed/Float_Mount_v6_mini-a17-pro_Flush_Printed.3mf

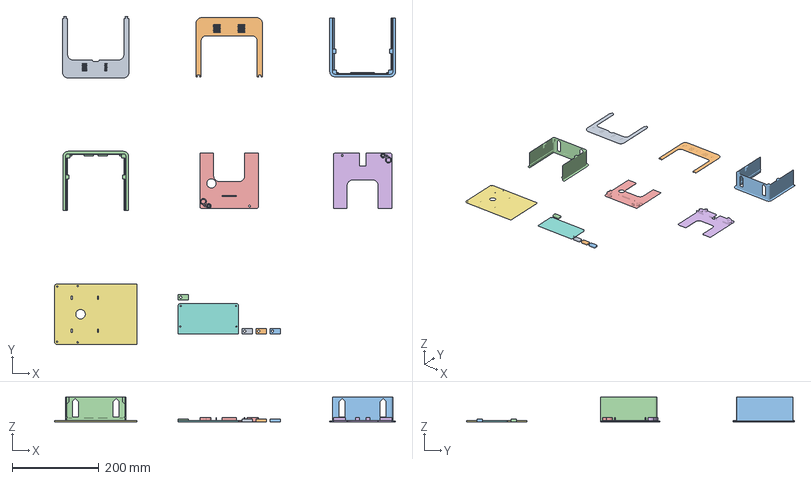
[picture p50: CAD file, 2026-10-20]
ipad_mini_a17_pro/flush/printed/Float_Mount_v6_mini-a17-pro_Flush_Printed.3mf
785.1 x 755.1 x 56.5 mm
trim_print_L
trim_print_R
sleeve_L
sleeve_R
deck_L
deck_R
back_plate_L
back_plate_R
dog_ear_arm_1
dog_ear_arm_2
dog_ear_arm_3
dog_ear_arm_4
