brendan779/ipad-pro-wall-mount/ipad_mini_a17_pro/flush/printed/print/deck_L.stl

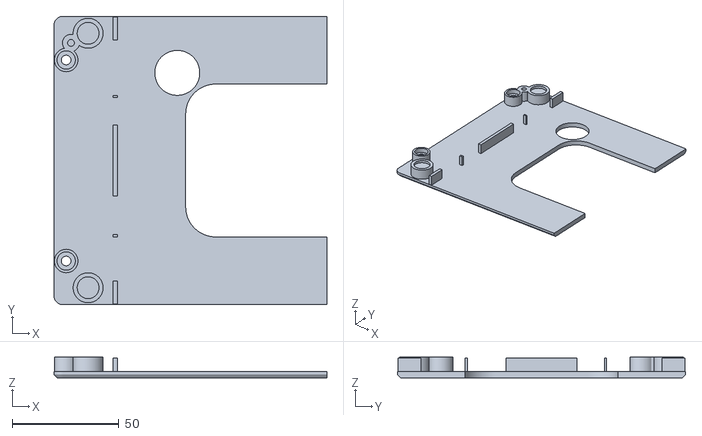
[picture p51: CAD file, 2026-10-20]
ipad_mini_a17_pro/flush/printed/print/deck_L.stl
127.7 x 134.9 x 9.62
