brendan779/ipad-pro-wall-mount/ipad_pro_11_m5/float/machined/print/wall_bracket.step

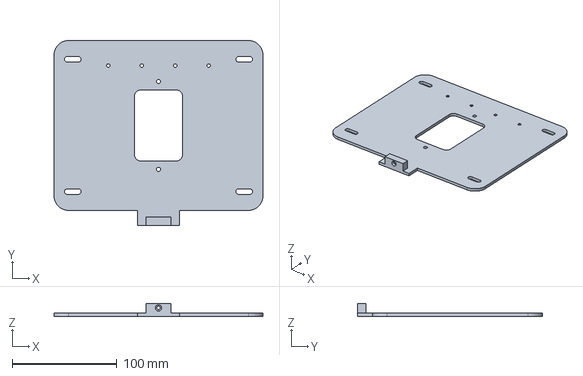
[picture p52: CAD file, 2026-10-20]
ipad_pro_11_m5/float/machined/print/wall_bracket.step
200.0 x 177.1 x 12.0 mm
