brendan779/ipad-pro-wall-mount/ipad_pro_11_m5/float/printed/print/shell_print_L.step

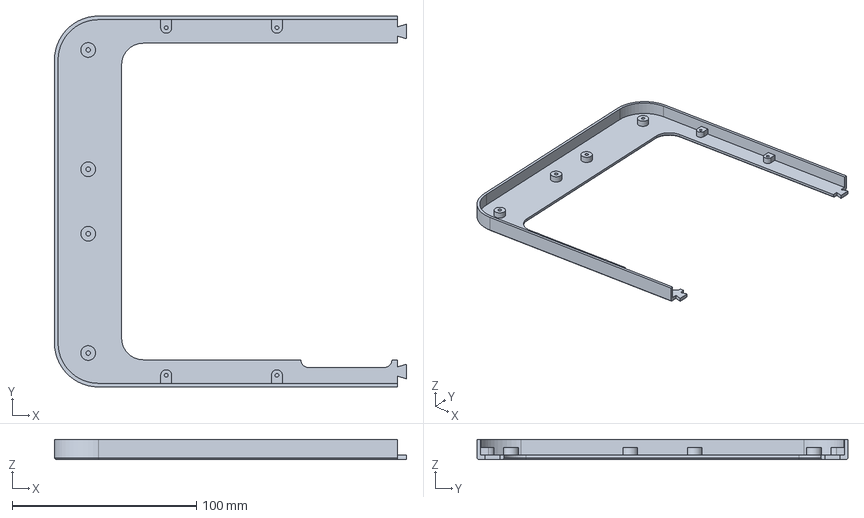
[picture p53: CAD file, 2026-10-20]
ipad_pro_11_m5/float/printed/print/shell_print_L.step
191.3 x 201.5 x 11.1 mm
