brendan779/ipad-pro-wall-mount/ipad_pro_11_m5/flush/machined/print/dog_ear_arm_x4.step

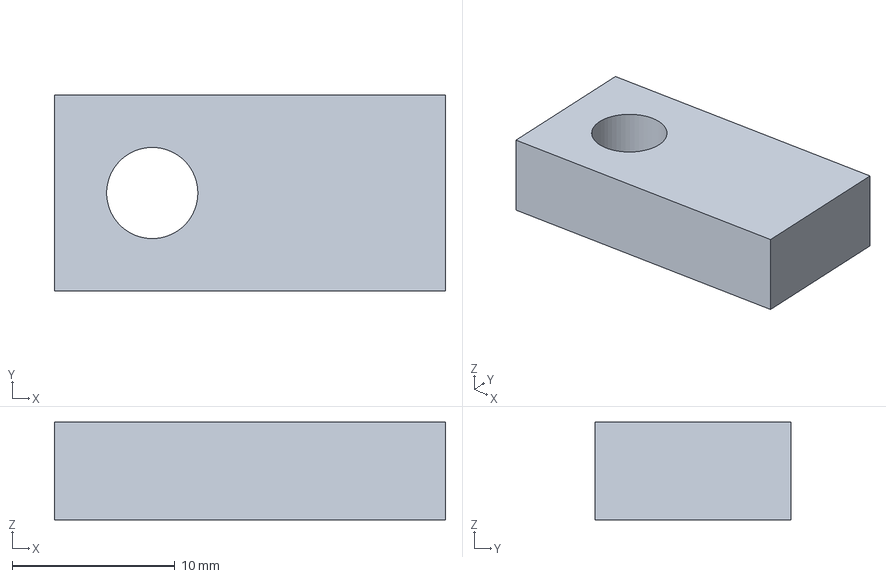
[picture p54: CAD file, 2026-10-20]
ipad_pro_11_m5/flush/machined/print/dog_ear_arm_x4.step
24.0 x 12.0 x 6.00 mm
