brendan779/ipad-pro-wall-mount/ipad_pro_12_9_gen3/float/machined/print/catch_rail.step

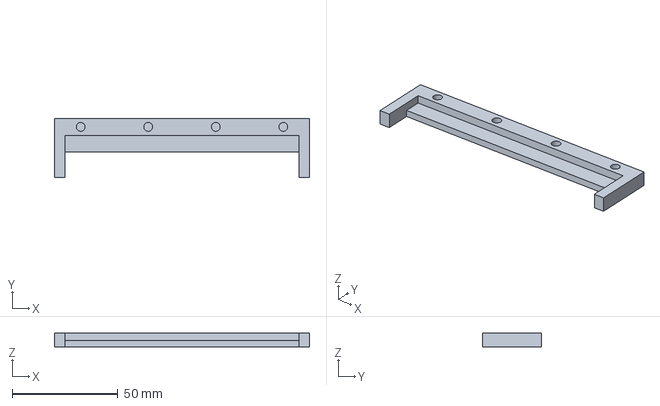
[picture p57: CAD file, 2026-10-20]
ipad_pro_12_9_gen3/float/machined/print/catch_rail.step
120.8 x 28.0 x 6.60 mm
