brendan779/ipad-pro-wall-mount/ipad_pro_12_9_gen3/flush/printed/print/trim_print_R.step

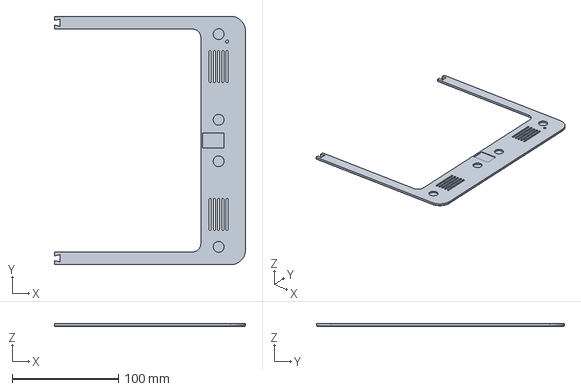
[picture p60: CAD file, 2026-10-20]
ipad_pro_12_9_gen3/flush/printed/print/trim_print_R.step
179.6 x 233.6 x 3.00 mm
