brendan779/ipad-pro-wall-mount/ipad_pro_13_m5/float/machined/machine/shell_6061.step

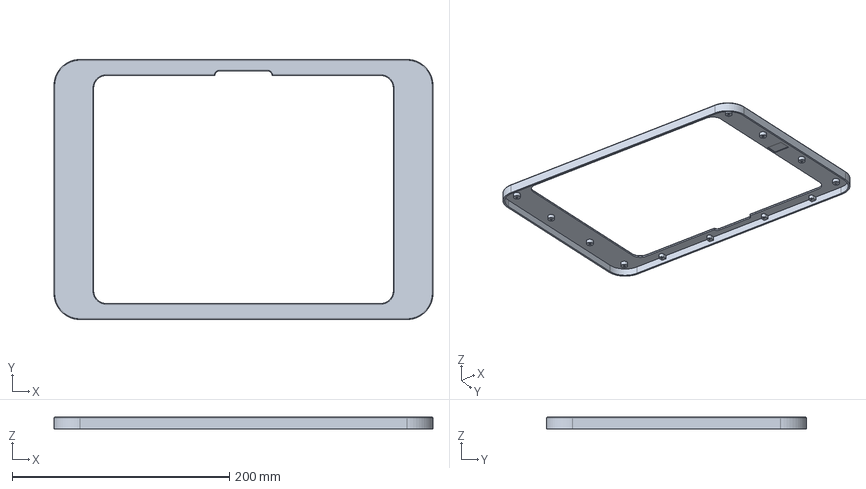
[picture p61: CAD file, 2026-10-20]
ipad_pro_13_m5/float/machined/machine/shell_6061.step
349.1 x 239.5 x 10.9 mm
