brendan779/ipad-pro-wall-mount/ipad_pro_13_m5/float/machined/print/lock_boss.step

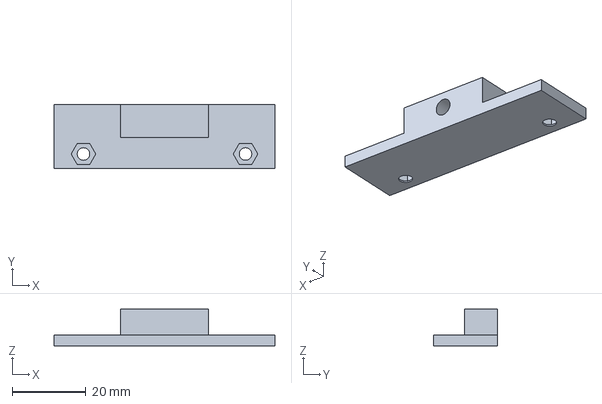
[picture p62: CAD file, 2026-10-20]
ipad_pro_13_m5/float/machined/print/lock_boss.step
60.0 x 17.5 x 10.0 mm
