brendan779/ipad-pro-wall-mount/ipad_pro_13_m5/flush/machined/print/deck_L.step

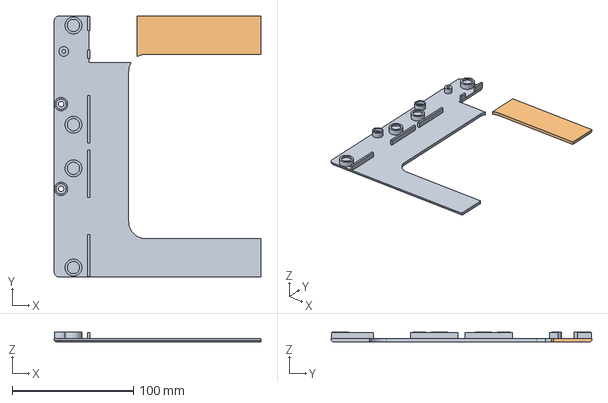
[picture p64: CAD file, 2026-10-20]
ipad_pro_13_m5/flush/machined/print/deck_L.step
170.7 x 215.6 x 8.43 mm
