brendan779/ipad-pro-wall-mount/ipad_pro_13_m5/flush/printed/Float_Mount_v6_pro-13-m5_Flush_Printed.3mf

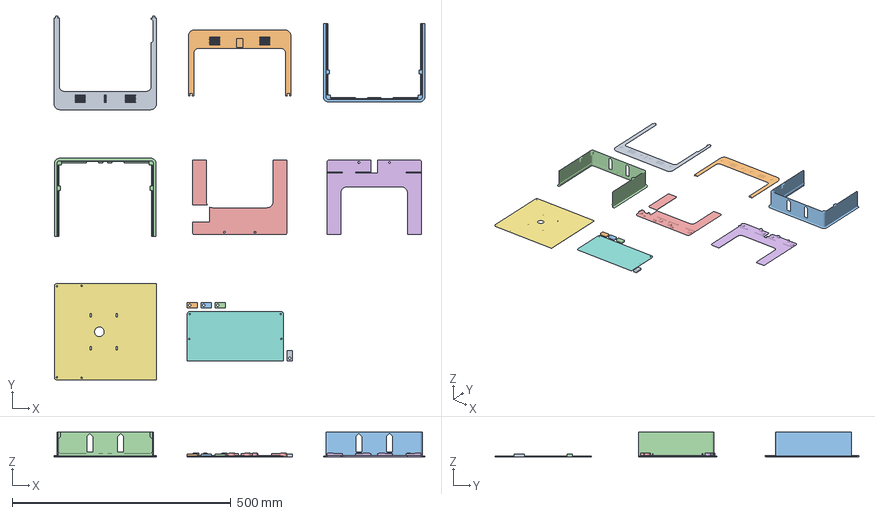
[picture p65: CAD file, 2026-10-20]
ipad_pro_13_m5/flush/printed/Float_Mount_v6_pro-13-m5_Flush_Printed.3mf
847.6 x 831.6 x 56.5 mm
trim_print_L
trim_print_R
sleeve_L
sleeve_R
deck_L
deck_R
back_plate_L
back_plate_R
dog_ear_arm_1
dog_ear_arm_2
dog_ear_arm_3
dog_ear_arm_4
