brendan779/ipad-pro-wall-mount/ipad_pro_13_m5/flush/printed/print/trim_print_R.step

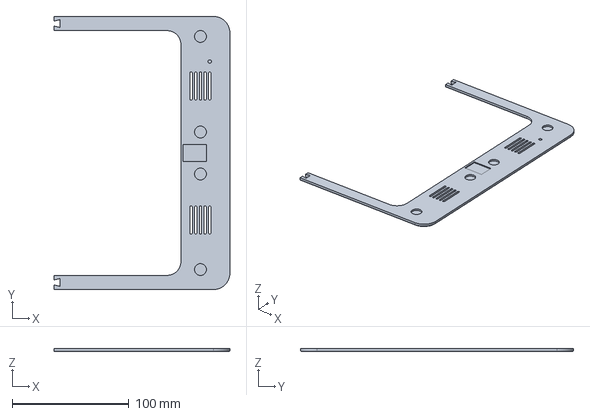
[picture p66: CAD file, 2026-10-20]
ipad_pro_13_m5/flush/printed/print/trim_print_R.step
150.8 x 234.2 x 3.00 mm
