brendan779/ipad-pro-wall-mount/ipad_mini_a17_pro/float/printed/Float_Mount_v6_mini-a17-pro_Float_Printed.3mf

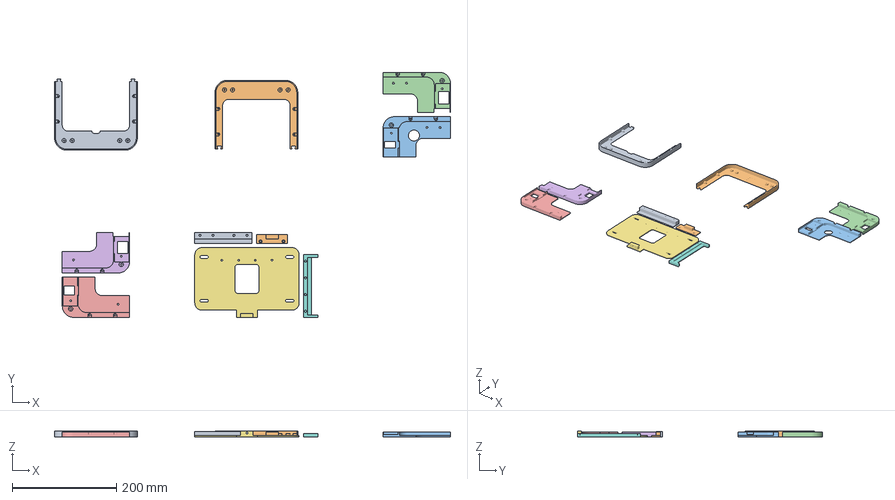
[picture p67: CAD file, 2026-10-20]
ipad_mini_a17_pro/float/printed/Float_Mount_v6_mini-a17-pro_Float_Printed.3mf
758.4 x 470.1 x 12.1 mm
shell_print_L
shell_print_R
carrier_TL
carrier_TR
carrier_BL
carrier_BR
wall_bracket
catch_rail
hanger
lock_boss
