brendan779/ipad-pro-wall-mount/ipad_mini_a17_pro/flush/printed/print/trim_print_R.step

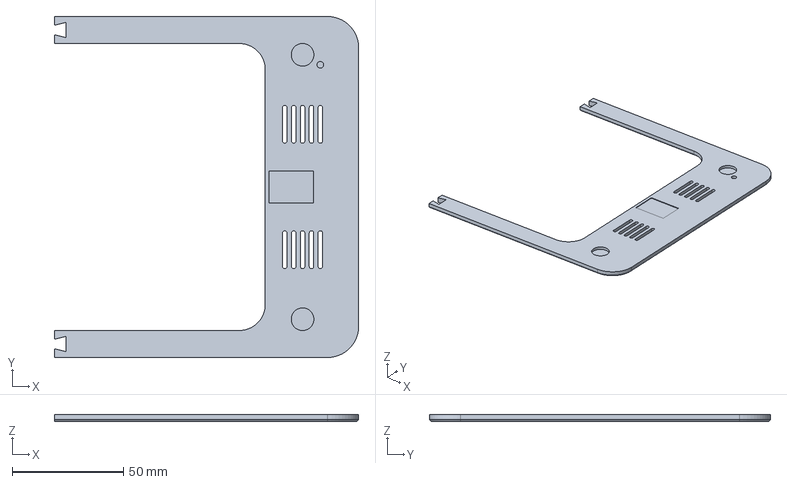
[picture p69: CAD file, 2026-10-20]
ipad_mini_a17_pro/flush/printed/print/trim_print_R.step
137.0 x 153.4 x 3.00 mm
