brendan779/ipad-pro-wall-mount/ipad_pro_11_m5/float/machined/print/carrier_TR.step

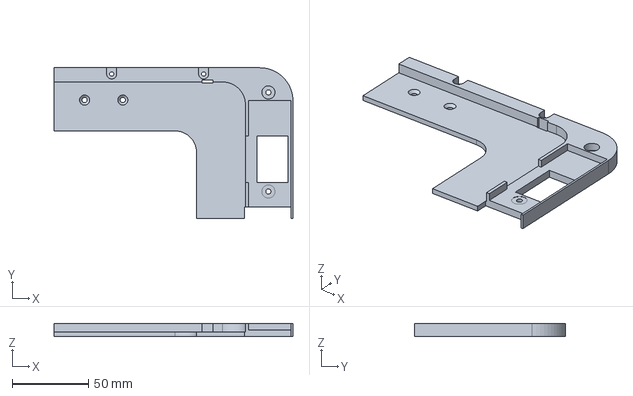
[picture p70: CAD file, 2026-10-20]
ipad_pro_11_m5/float/machined/print/carrier_TR.step
156.3 x 98.5 x 8.59 mm
