brendan779/ipad-pro-wall-mount/ipad_pro_11_m5/float/printed/Float_Mount_v6_pro-11-m5_Float_Printed.3mf

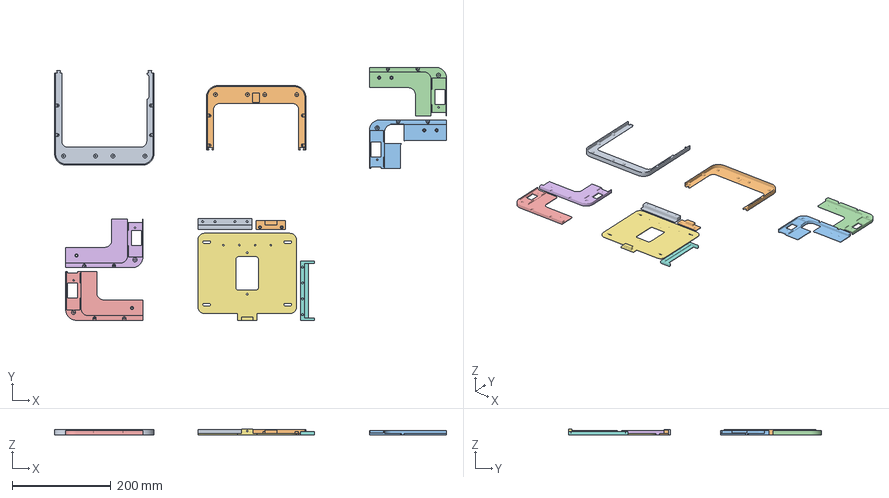
[picture p71: CAD file, 2026-10-20]
ipad_pro_11_m5/float/printed/Float_Mount_v6_pro-11-m5_Float_Printed.3mf
793.3 x 512.9 x 12.0 mm
shell_print_L
shell_print_R
carrier_TL
carrier_TR
carrier_BL
carrier_BR
wall_bracket
catch_rail
hanger
lock_boss
