brendan779/ipad-pro-wall-mount/ipad_pro_11_m5/float/printed/print/carrier_TL.stl

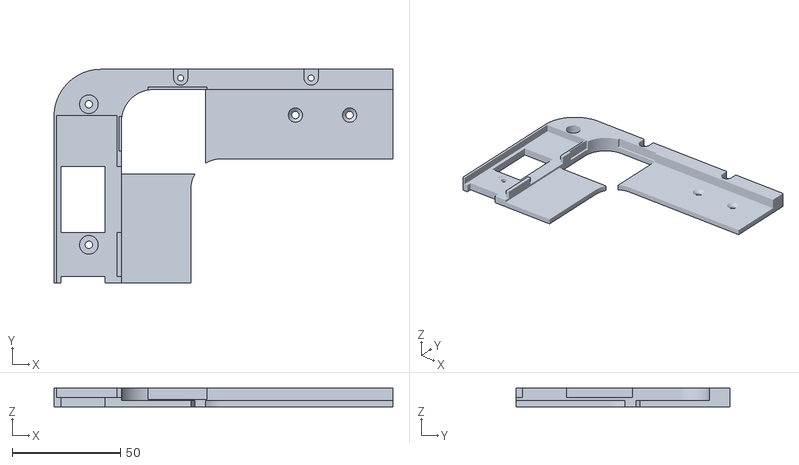
[picture p72: CAD file, 2026-10-20]
ipad_pro_11_m5/float/printed/print/carrier_TL.stl
156.3 x 98.5 x 8.59
