brendan779/ipad-pro-wall-mount/ipad_pro_11_m5/flush/machined/print/back_plate_L.step

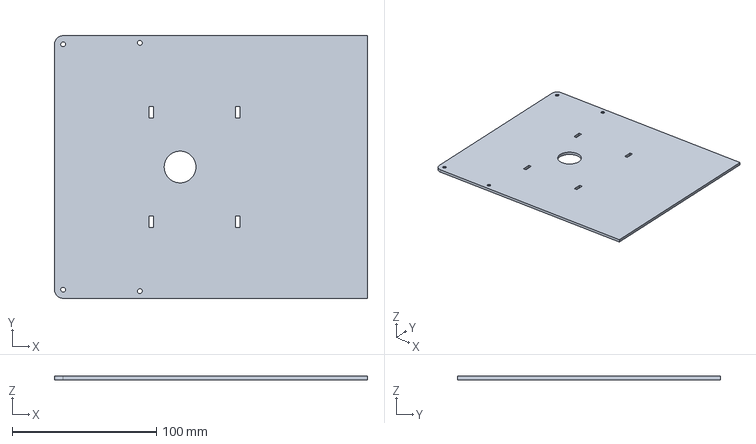
[picture p73: CAD file, 2026-10-20]
ipad_pro_11_m5/flush/machined/print/back_plate_L.step
217.1 x 182.2 x 2.50 mm
