brendan779/ipad-pro-wall-mount/ipad_pro_11_m5/flush/printed/print/trim_print_R.step

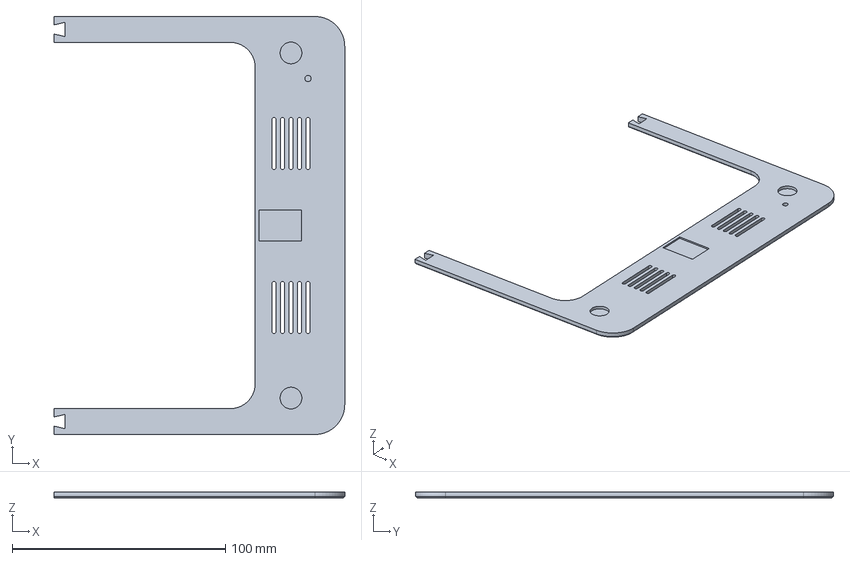
[picture p74: CAD file, 2026-10-20]
ipad_pro_11_m5/flush/printed/print/trim_print_R.step
136.4 x 196.2 x 3.00 mm
