brendan779/ipad-pro-wall-mount/ipad_pro_12_9_gen3/float/machined/print/wall_bracket.step

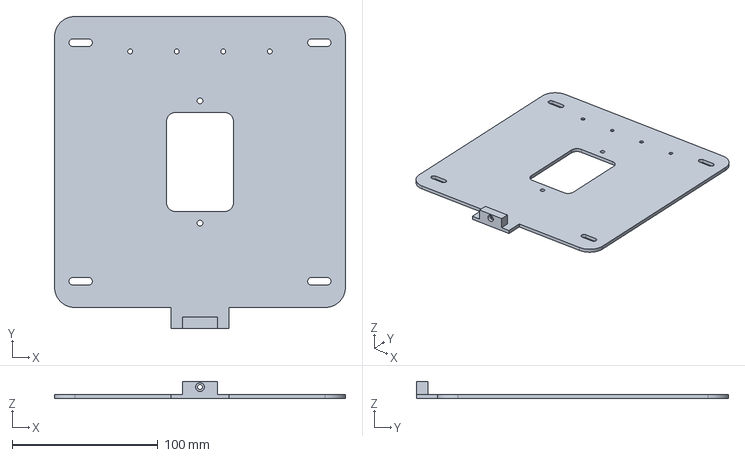
[picture p75: CAD file, 2026-10-20]
ipad_pro_12_9_gen3/float/machined/print/wall_bracket.step
200.0 x 214.4 x 12.0 mm
