brendan779/ipad-pro-wall-mount/ipad_pro_12_9_gen3/float/printed/Float_Mount_v6_pro-12-9-gen3_Float_Printed.3mf

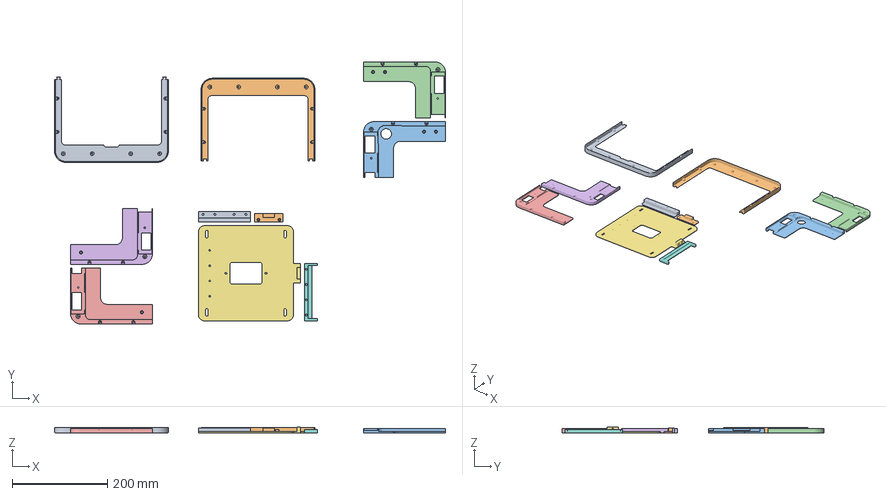
[picture p76: CAD file, 2026-10-20]
ipad_pro_12_9_gen3/float/printed/Float_Mount_v6_pro-12-9-gen3_Float_Printed.3mf
819.7 x 549.5 x 12.0 mm
shell_print_L
shell_print_R
carrier_TL
carrier_TR
carrier_BL
carrier_BR
wall_bracket
catch_rail
hanger
lock_boss
