brendan779/ipad-pro-wall-mount/ipad_pro_12_9_gen3/float/printed/print/shell_print_R.step

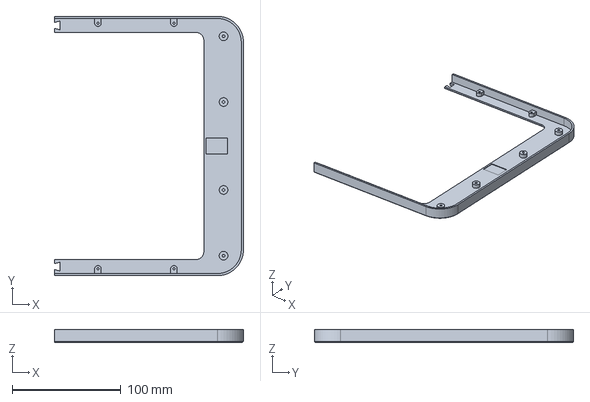
[picture p77: CAD file, 2026-10-20]
ipad_pro_12_9_gen3/float/printed/print/shell_print_R.step
174.1 x 238.9 x 11.7 mm
