brendan779/ipad-pro-wall-mount/ipad_pro_12_9_gen3/flush/machined/print/deck_R.step

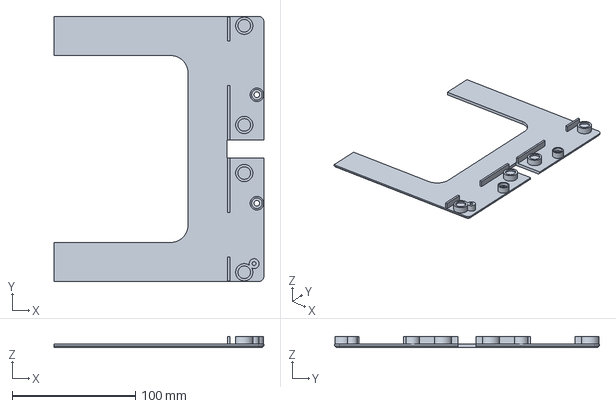
[picture p78: CAD file, 2026-10-20]
ipad_pro_12_9_gen3/flush/machined/print/deck_R.step
170.2 x 215.0 x 9.20 mm
