brendan779/ipad-pro-wall-mount/ipad_pro_13_m5/float/printed/print/shell_print_R.step

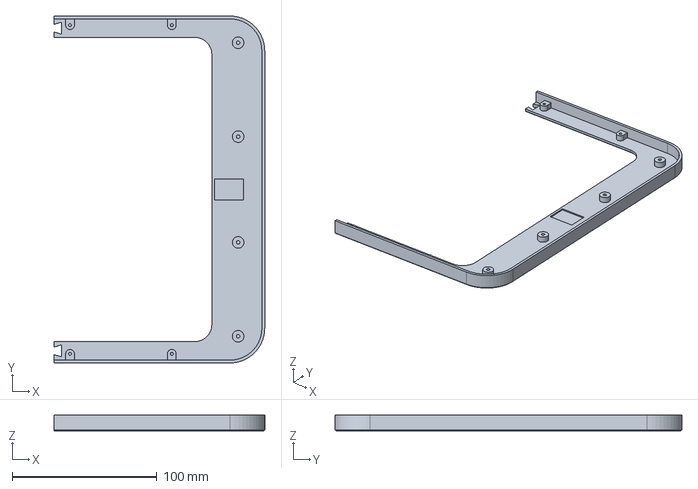
[picture p79: CAD file, 2026-10-20]
ipad_pro_13_m5/float/printed/print/shell_print_R.step
145.3 x 239.5 x 10.9 mm
