brendan779/ipad-pro-wall-mount/ipad_pro_13_m5/flush/printed/print/trim_print_L.step

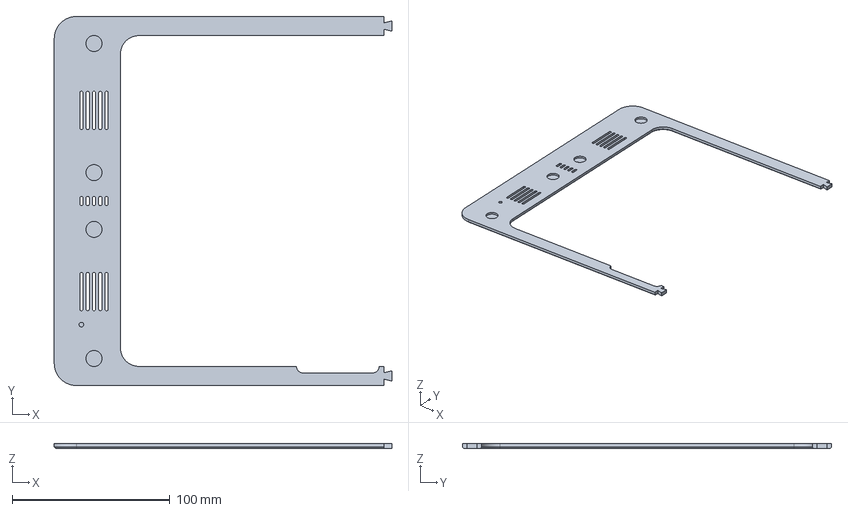
[picture p80: CAD file, 2026-10-20]
ipad_pro_13_m5/flush/printed/print/trim_print_L.step
214.3 x 234.2 x 3.00 mm
