brendan779/ipad-pro-wall-mount/ipad_mini_a17_pro/float/machined/print/carrier_BL.step

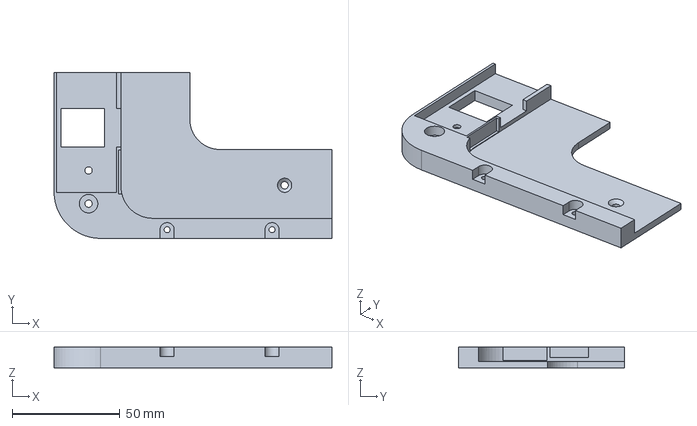
[picture p81: CAD file, 2026-10-20]
ipad_mini_a17_pro/float/machined/print/carrier_BL.step
129.2 x 77.1 x 9.62 mm
