brendan779/ipad-pro-wall-mount/ipad_pro_11_m5/flush/machined/print/sleeve_L.step

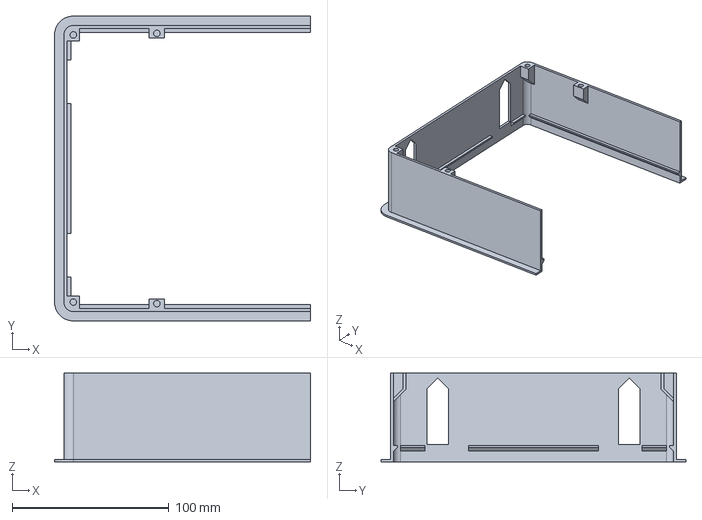
[picture p83: CAD file, 2026-10-20]
ipad_pro_11_m5/flush/machined/print/sleeve_L.step
163.1 x 194.2 x 56.5 mm
