brendan779/ipad-pro-wall-mount/ipad_pro_11_m5/flush/printed/print/trim_print_L.step

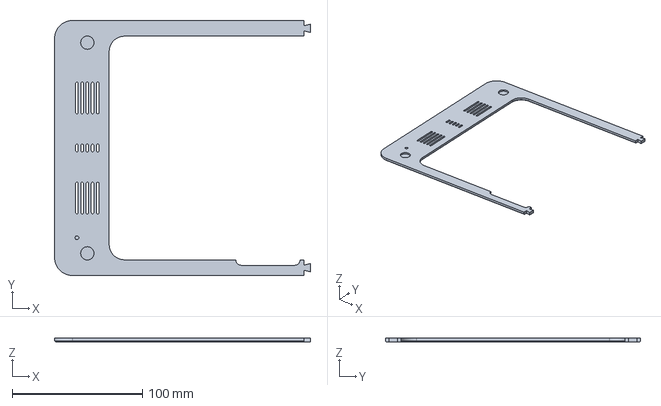
[picture p84: CAD file, 2026-10-20]
ipad_pro_11_m5/flush/printed/print/trim_print_L.step
196.8 x 196.2 x 3.00 mm
