brendan779/ipad-pro-wall-mount/ipad_pro_12_9_gen3/float/machined/print/carrier_BR.step

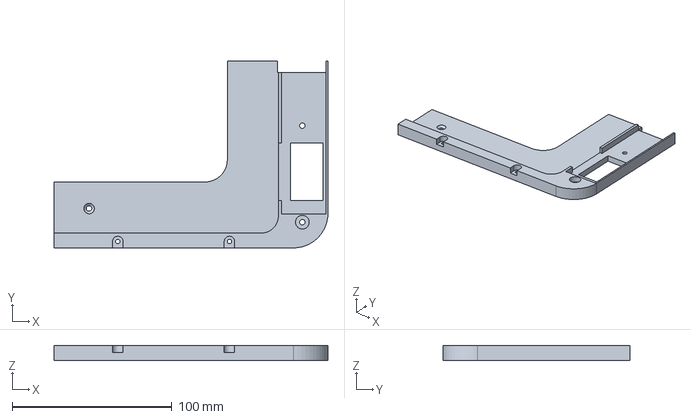
[picture p85: CAD file, 2026-10-20]
ipad_pro_12_9_gen3/float/machined/print/carrier_BR.step
171.8 x 117.2 x 9.20 mm
