brendan779/ipad-pro-wall-mount/ipad_pro_12_9_gen3/flush/printed/print/back_plate_L.stl

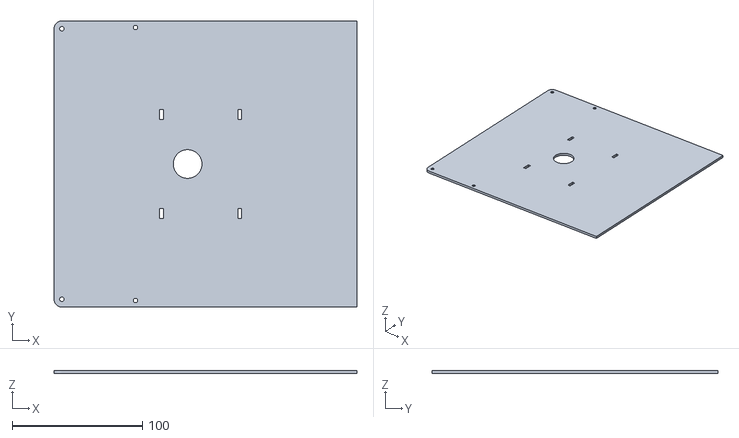
[picture p86: CAD file, 2026-10-20]
ipad_pro_12_9_gen3/flush/printed/print/back_plate_L.stl
232.6 x 219.6 x 2.50
