brendan779/ipad-pro-wall-mount/ipad_pro_13_m5/float/printed/print/carrier_TR.stl

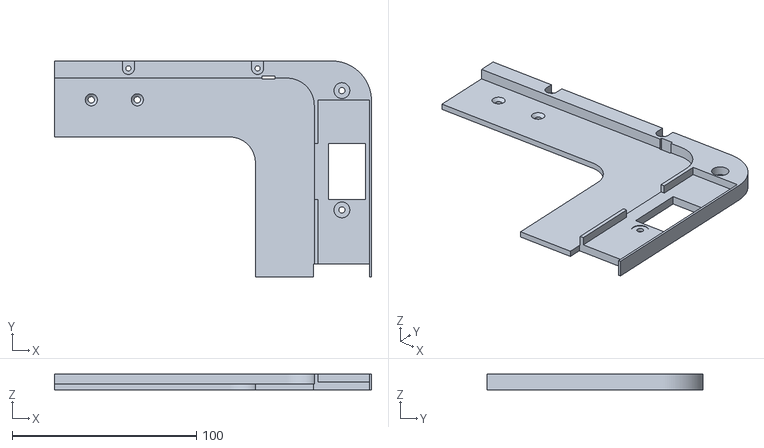
[picture p87: CAD file, 2026-10-20]
ipad_pro_13_m5/float/printed/print/carrier_TR.stl
172.2 x 117.5 x 8.43
