brendan779/ipad-pro-wall-mount/ipad_pro_13_m5/flush/machined/print/back_plate_R.step

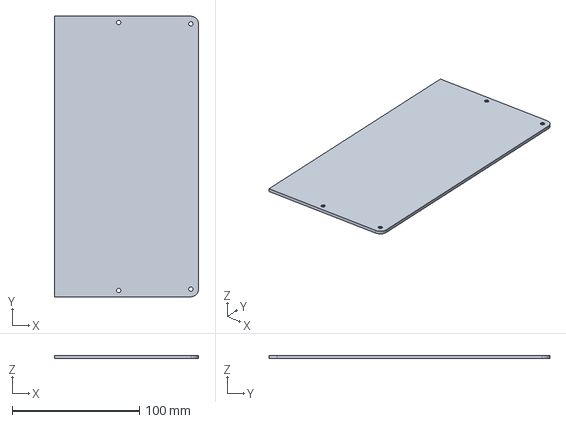
[picture p88: CAD file, 2026-10-20]
ipad_pro_13_m5/flush/machined/print/back_plate_R.step
113.0 x 220.2 x 2.50 mm
