brendan779/ipad-pro-wall-mount/ipad_pro_13_m5/flush/printed/print/deck_R.stl

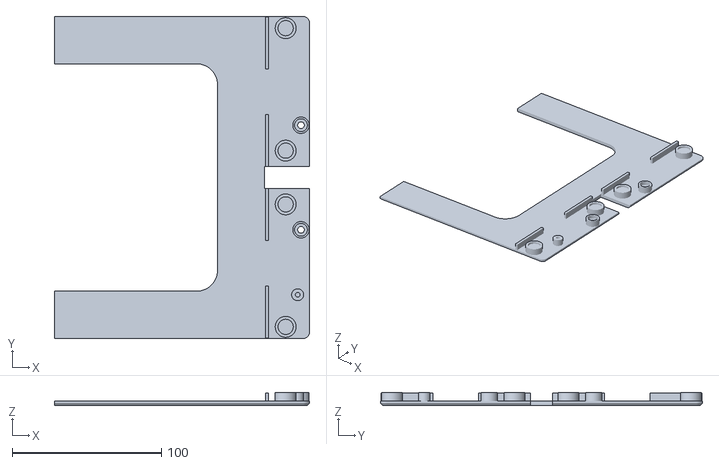
[picture p89: CAD file, 2026-10-20]
ipad_pro_13_m5/flush/printed/print/deck_R.stl
170.7 x 215.6 x 8.43
