brendan779/ipad-pro-wall-mount/ipad_mini_a17_pro/float/machined/print/wall_bracket.step

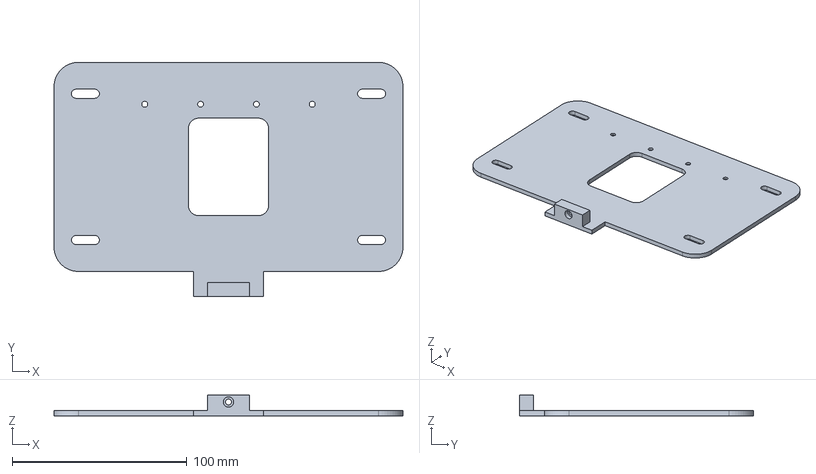
[picture p90: CAD file, 2026-10-20]
ipad_mini_a17_pro/float/machined/print/wall_bracket.step
200.0 x 134.3 x 12.0 mm
