brendan779/ipad-pro-wall-mount/ipad_pro_11_m5/flush/printed/print/deck_R.stl

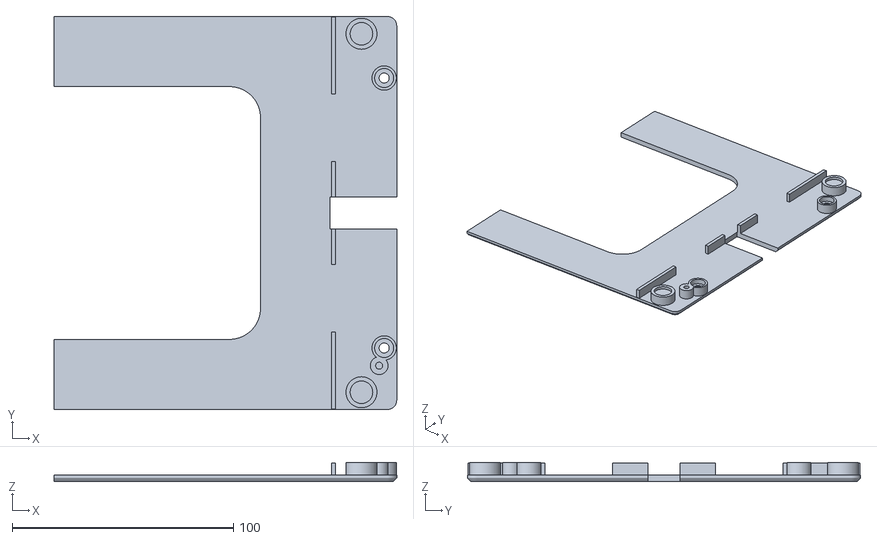
[picture p91: CAD file, 2026-10-20]
ipad_pro_11_m5/flush/printed/print/deck_R.stl
154.8 x 177.6 x 8.59
