brendan779/ipad-pro-wall-mount/ipad_pro_12_9_gen3/flush/machined/print/sleeve_L.step

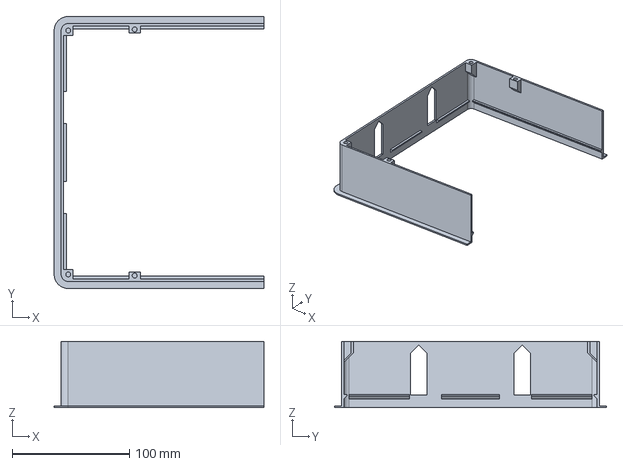
[picture p92: CAD file, 2026-10-20]
ipad_pro_12_9_gen3/flush/machined/print/sleeve_L.step
178.6 x 231.6 x 56.5 mm
