brendan779/ipad-pro-wall-mount/ipad_pro_13_m5/float/printed/print/shell_print_L.step

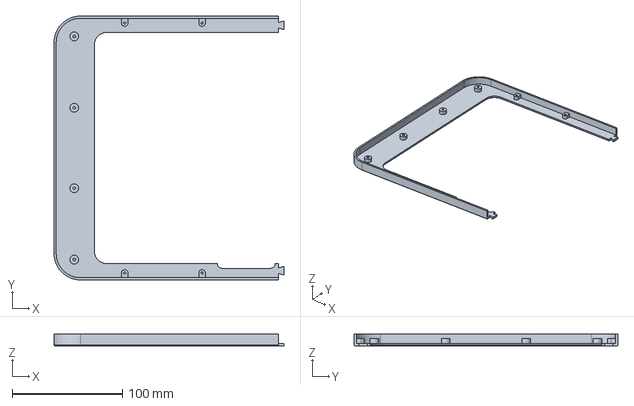
[picture p93: CAD file, 2026-10-20]
ipad_pro_13_m5/float/printed/print/shell_print_L.step
208.8 x 239.5 x 10.9 mm
