brendan779/ipad-pro-wall-mount/ipad_mini_a17_pro/flush/machined/print/sleeve_L.step

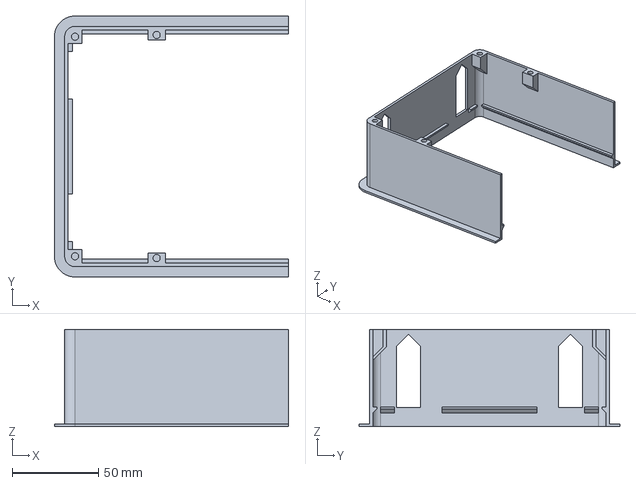
[picture p94: CAD file, 2026-10-20]
ipad_mini_a17_pro/flush/machined/print/sleeve_L.step
136.0 x 151.4 x 56.5 mm
