brendan779/ipad-pro-wall-mount/ipad_pro_11_m5/flush/printed/print/back_plate_R.stl

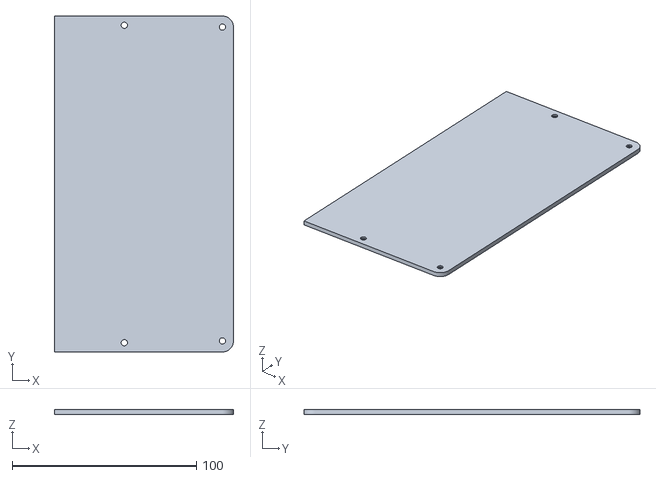
[picture p95: CAD file, 2026-10-20]
ipad_pro_11_m5/flush/printed/print/back_plate_R.stl
97.1 x 182.2 x 2.50
