brendan779/ipad-pro-wall-mount/(list of files, cad)

Other CAD files:
ipad_mini_a17_pro/float/printed/assembly_float6_printed.step
ipad_pro_11_m5/float/printed/assembly_float6_printed.step
ipad_pro_12_9_gen3/float/printed/assembly_float6_printed.step
ipad_pro_12_9_gen3/flush/machined/assembly_flush6.step
ipad_pro_13_m5/float/printed/assembly_float6_printed.step
ipad_pro_13_m5/float/printed/print/one_piece/carrier_full.stl
ipad_pro_13_m5/flush/machined/assembly_flush6.step
ipad_mini_a17_pro/float/printed/print/one_piece/carrier_full.stl
ipad_mini_a17_pro/flush/printed/assembly_flush6_printed.step
ipad_pro_11_m5/float/printed/print/one_piece/carrier_full.stl
ipad_pro_11_m5/flush/machined/print/one_piece/deck_full.step
ipad_pro_11_m5/flush/printed/assembly_flush6_printed.step
ipad_pro_12_9_gen3/float/printed/print/one_piece/carrier_full.stl
ipad_pro_12_9_gen3/flush/printed/assembly_flush6_printed.step
ipad_pro_13_m5/flush/machined/print/one_piece/back_plate_full.step
ipad_pro_13_m5/flush/printed/assembly_flush6_printed.step
ipad_pro_13_m5/flush/printed/print/one_piece/deck_full.stl
ipad_mini_a17_pro/flush/machined/print/one_piece/deck_full.step
ipad_mini_a17_pro/flush/printed/print/one_piece/back_plate_full.stl
ipad_pro_11_m5/flush/printed/print/one_piece/sleeve_full.stl
ipad_pro_12_9_gen3/flush/machined/print/one_piece/sleeve_full.step
ipad_pro_12_9_gen3/flush/printed/print/one_piece/deck_full.stl
ipad_pro_13_m5/flush/machined/print/one_piece/sleeve_full.step
ipad_pro_13_m5/flush/printed/print/one_piece/sleeve_full.stl
ipad_mini_a17_pro/flush/printed/print/one_piece/sleeve_full.stl
ipad_pro_11_m5/flush/printed/print/one_piece/back_plate_full.stl
ipad_pro_12_9_gen3/flush/printed/print/one_piece/back_plate_full.stl
ipad_pro_13_m5/flush/printed/print/one_piece/back_plate_full.stl
ipad_mini_a17_pro/float/machined/machine/shell_6061.step
ipad_pro_11_m5/float/machined/machine/shell_6061.step
ipad_pro_11_m5/flush/machined/machine/trim_6061.step
ipad_pro_12_9_gen3/float/machined/machine/shell_6061.step
ipad_pro_12_9_gen3/flush/machined/machine/trim_6061.step
ipad_pro_12_9_gen3/flush/machined/print/dog_ear_arm_x4.step
ipad_pro_13_m5/flush/machined/machine/trim_6061.step
ipad_mini_a17_pro/float/machined/print/catch_rail.step
ipad_mini_a17_pro/flush/machined/print/dog_ear_arm_x4.step
ipad_pro_12_9_gen3/flush/printed/print/trim_print_L.step
ipad_pro_13_m5/float/machined/print/carrier_TL.step
ipad_pro_13_m5/float/printed/Float_Mount_v6_pro-13-m5_Float_Printed.3mf
ipad_pro_13_m5/flush/machined/print/dog_ear_arm_x4.step
ipad_mini_a17_pro/float/printed/print/carrier_TL.stl
ipad_mini_a17_pro/flush/machined/print/deck_R.step
ipad_mini_a17_pro/flush/printed/print/deck_R.stl
ipad_pro_11_m5/float/machined/print/catch_rail.step
ipad_pro_12_9_gen3/float/printed/print/carrier_BL.stl
ipad_pro_12_9_gen3/flush/machined/print/deck_L.step
ipad_pro_13_m5/float/machined/print/hanger.step
ipad_mini_a17_pro/float/printed/print/catch_rail.stl
ipad_mini_a17_pro/flush/machined/print/deck_L.step
ipad_mini_a17_pro/flush/printed/print/trim_print_L.step
ipad_pro_11_m5/float/machined/print/lock_boss.step
ipad_pro_11_m5/float/printed/print/carrier_BL.stl
ipad_pro_11_m5/flush/machined/print/deck_L.step
ipad_pro_12_9_gen3/float/machined/print/carrier_BL.step
ipad_pro_12_9_gen3/float/printed/print/carrier_TR.stl
ipad_pro_12_9_gen3/flush/printed/print/sleeve_R.stl
ipad_pro_13_m5/float/machined/print/catch_rail.step
ipad_pro_13_m5/flush/machined/print/back_plate_L.step
ipad_pro_13_m5/flush/printed/print/deck_L.stl
ipad_mini_a17_pro/float/machined/print/carrier_TL.step
ipad_mini_a17_pro/float/printed/print/carrier_TR.stl
ipad_mini_a17_pro/flush/printed/print/sleeve_R.stl
ipad_pro_11_m5/float/machined/print/carrier_BL.step
ipad_pro_11_m5/float/printed/print/carrier_TR.stl
ipad_pro_11_m5/flush/machined/print/deck_R.step
ipad_pro_12_9_gen3/float/machined/print/lock_boss.step
ipad_pro_12_9_gen3/float/printed/print/catch_rail.stl
float-v4.1/assembly_hybrid_v4_1.step
float-v4.1/carrier_full_reference.step
float-v4.1/machine/shell_6061.step
float-v4.1/machine/shell_6061.stl
float-v4.1/print/optional_shell_prototype/shell_print_BL.stl
float-v4.1/print/optional_shell_prototype/shell_print_BR.stl
float-v4.1/print/optional_shell_prototype/shell_print_TL.stl
float-v4.1/print/optional_shell_prototype/shell_print_TR.stl
float-v4.2/machine/shell_6061.step
float-v4.2/machine/shell_6061.stl
float-v4.2/print/carrier_BL.step
float-v4.2/print/carrier_BL.stl
float-v4.2/print/carrier_BR.step
float-v4.2/print/carrier_BR.stl
float-v4.2/print/carrier_TL.step
float-v4.2/print/carrier_TL.stl
float-v4.2/print/carrier_TR.step
float-v4.2/print/carrier_TR.stl
float-v4.2/print/catch_rail.step
float-v4.2/print/catch_rail.stl
float-v4.2/print/hanger.step
float-v4.2/print/lock_boss.step
float-v4.2/print/one_piece/carrier_full.step
float-v4.2/print/one_piece/carrier_full.stl
float-v4.2/print/wall_bracket.step
flush-v5.1/machine/trim_6061.step
flush-v5.1/machine/trim_6061.stl
flush-v5.1/print/back_plate_L.step
flush-v5.1/print/back_plate_R.step
flush-v5.1/print/deck_L.step
flush-v5.1/print/deck_R.step
flush-v5.1/print/dog_ear_arm_x4.step
flush-v5.1/print/sleeve_L.step
flush-v5.1/print/sleeve_R.step
fully-printed/float-v4.1-printed/Float_Mount_v4.1_Printed.3mf
fully-printed/float-v4.2-printed/print/carrier_BL.stl
fully-printed/float-v4.2-printed/print/carrier_BR.stl
fully-printed/float-v4.2-printed/print/carrier_TL.stl
fully-printed/float-v4.2-printed/print/carrier_TR.stl
fully-printed/float-v4.2-printed/print/catch_rail.stl
fully-printed/float-v4.2-printed/print/one_piece/carrier_full.stl
fully-printed/float-v4.2-printed/print/one_piece/shell_print_full.step
fully-printed/float-v4.2-printed/print/one_piece/shell_print_full.stl
fully-printed/float-v4.2-printed/print/shell_print_L.step
fully-printed/float-v4.2-printed/print/shell_print_L.stl
fully-printed/float-v4.2-printed/print/shell_print_R.step
fully-printed/float-v4.2-printed/print/shell_print_R.stl
fully-printed/flush-v5.1-printed/print/back_plate_L.stl
fully-printed/flush-v5.1-printed/print/back_plate_R.stl
fully-printed/flush-v5.1-printed/print/deck_L.stl
fully-printed/flush-v5.1-printed/print/deck_R.stl
fully-printed/flush-v5.1-printed/print/sleeve_L.stl
fully-printed/flush-v5.1-printed/print/sleeve_R.stl
fully-printed/flush-v5.1-printed/print/trim_print_L.step
fully-printed/flush-v5.1-printed/print/trim_print_L.stl
fully-printed/flush-v5.1-printed/print/trim_print_R.step
fully-printed/flush-v5.1-printed/print/trim_print_R.stl
ipad_mini_a17_pro/float/machined/machine/shell_6061.stl
ipad_mini_a17_pro/float/machined/print/carrier_BL.stl
ipad_mini_a17_pro/float/machined/print/carrier_BR.step
ipad_mini_a17_pro/float/machined/print/carrier_BR.stl
ipad_mini_a17_pro/float/machined/print/carrier_TL.stl
ipad_mini_a17_pro/float/machined/print/carrier_TR.step
ipad_mini_a17_pro/float/machined/print/carrier_TR.stl
ipad_mini_a17_pro/float/machined/print/catch_rail.stl
ipad_mini_a17_pro/float/machined/print/hanger.stl
ipad_mini_a17_pro/float/machined/print/lock_boss.step
ipad_mini_a17_pro/float/machined/print/lock_boss.stl
ipad_mini_a17_pro/float/machined/print/one_piece/carrier_full.stl
ipad_mini_a17_pro/float/machined/print/wall_bracket.stl
ipad_mini_a17_pro/float/printed/print/carrier_BL.stl
ipad_mini_a17_pro/float/printed/print/carrier_BR.stl
ipad_mini_a17_pro/float/printed/print/hanger.stl
ipad_mini_a17_pro/float/printed/print/lock_boss.stl
ipad_mini_a17_pro/float/printed/print/one_piece/shell_print_full.stl
ipad_mini_a17_pro/float/printed/print/shell_print_L.stl
ipad_mini_a17_pro/float/printed/print/shell_print_R.stl
ipad_mini_a17_pro/float/printed/print/wall_bracket.stl
ipad_mini_a17_pro/flush/machined/machine/trim_6061.stl
ipad_mini_a17_pro/flush/machined/print/back_plate_L.stl
ipad_mini_a17_pro/flush/machined/print/back_plate_R.step
ipad_mini_a17_pro/flush/machined/print/back_plate_R.stl
ipad_mini_a17_pro/flush/machined/print/deck_R.stl
ipad_mini_a17_pro/flush/machined/print/dog_ear_arm_x4.stl
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
