brendan779/ipad-pro-wall-mount/manuals/float/images/a9_cable.png

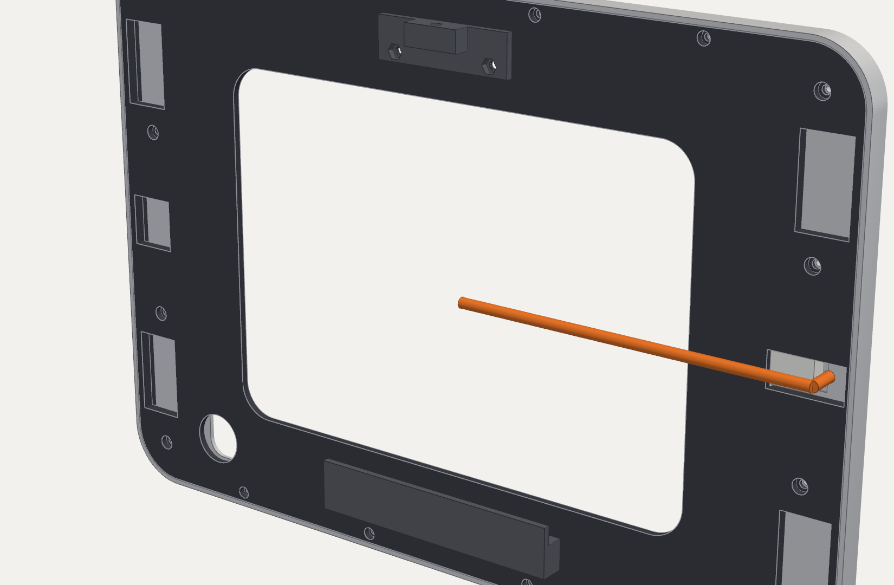
manuals/float/images/a9_cable.png
