brendan779/ipad-pro-wall-mount/ipad_mini_a17_pro/float/machined/machine/shell_6061_drawing.pdf

## FRONT VIEW (FACE A, COSMETIC) 1:2 SECTION B–B 4:1 (TYPICAL A1–A8)

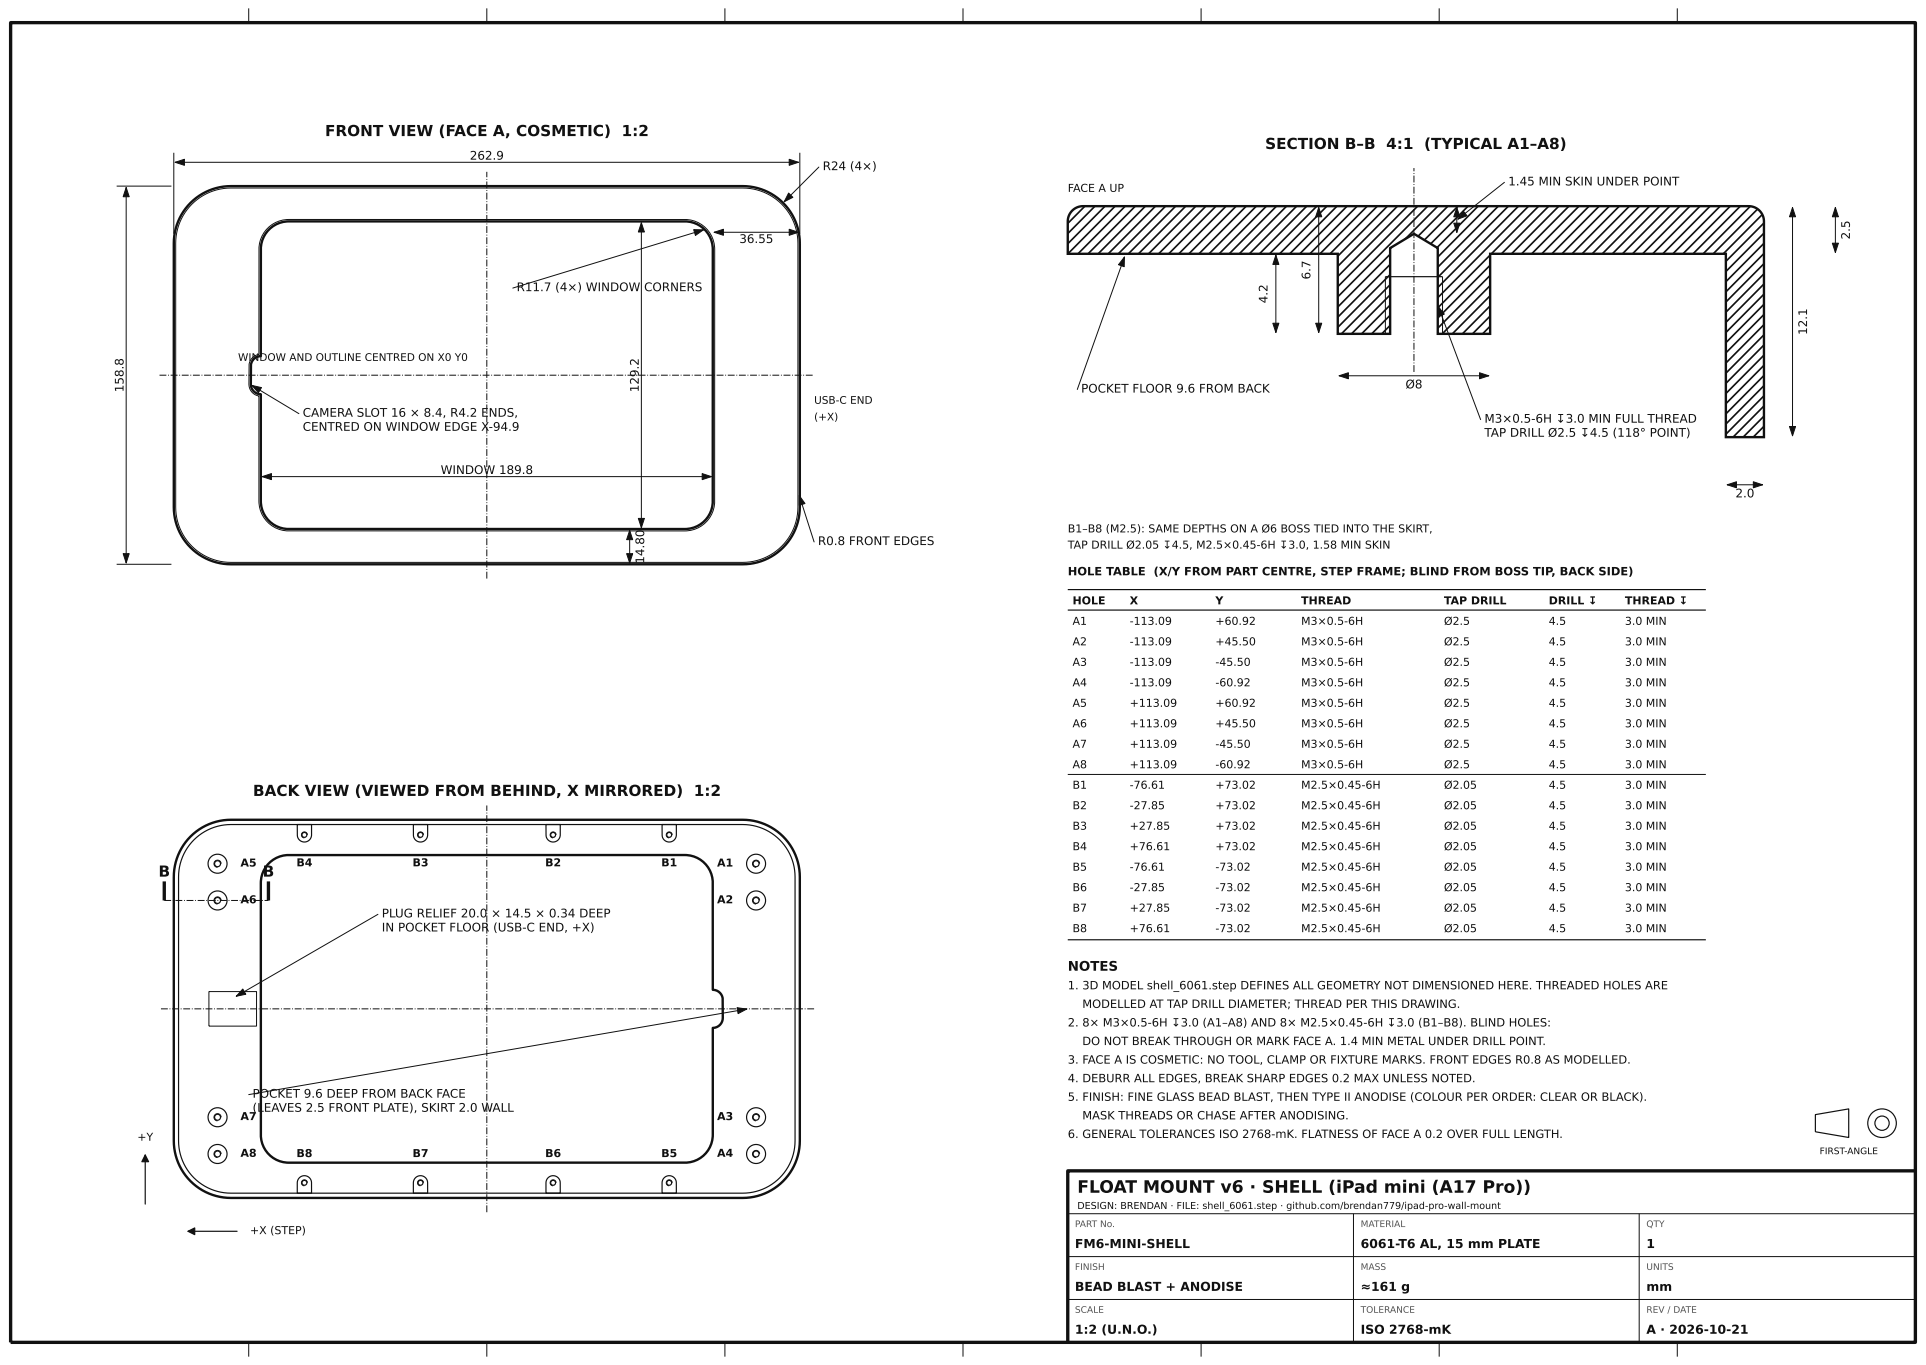
[picture p397: page 1]
WINDOW 189.8; R11.7 (4×) WINDOW CORNERS; R0.8 FRONT EDGES; USB-C END; +X (STEP); PLUG RELIEF 20.0; × 14.5 × 0.34 DEEP; FACE A UP; HOLE; THREAD; TAP DRILL; DRILL ↧; THREAD ↧; 3.0 MIN; PART No.; FM6-MINI-SHELL; QTY; MASS ≈161 g; UNITS; SCALE; TOLERANCE; ISO 2768-mK; REV / DATE; FIRST-ANGLE

1.45 MIN SKIN UNDER POINT

WINDOW AND OUTLINE CENTRED ON X0 Y0

POCKET FLOOR 9.6 FROM BACK

CAMERA SLOT 16 × 8.4, R4.2 ENDS,
CENTRED ON WINDOW EDGE X-94.9

M3×0.5-6H ↧3.0 MIN FULL THREAD
TAP DRILL Ø2.5 ↧4.5 (118° POINT)

B1–B8 (M2.5): SAME DEPTHS ON A Ø6 BOSS TIED INTO THE SKIRT,
TAP DRILL Ø2.05 ↧4.5, M2.5×0.45-6H ↧3.0, 1.58 MIN SKIN

HOLE TABLE (X/Y FROM PART CENTRE, STEP FRAME; BLIND FROM BOSS TIP, BACK SIDE)

BACK VIEW (VIEWED FROM BEHIND, X MIRRORED) 1:2

IN POCKET FLOOR (USB-C END, +X)

NOTES
1. 3D MODEL shell_6061.step DEFINES ALL GEOMETRY NOT DIMENSIONED HERE. THREADED HOLES ARE
MODELLED AT TAP DRILL DIAMETER; THREAD PER THIS DRAWING.
2. 8× M3×0.5-6H ↧3.0 (A1–A8) AND 8× M2.5×0.45-6H ↧3.0 (B1–B8). BLIND HOLES:

DO NOT BREAK THROUGH OR MARK FACE A. 1.4 MIN METAL UNDER DRILL POINT.
3. FACE A IS COSMETIC: NO TOOL, CLAMP OR FIXTURE MARKS. FRONT EDGES R0.8 AS MODELLED.
4. DEBURR ALL EDGES, BREAK SHARP EDGES 0.2 MAX UNLESS NOTED.
5. FINISH: FINE GLASS BEAD BLAST, THEN TYPE II ANODISE (COLOUR PER ORDER: CLEAR OR BLACK).
MASK THREADS OR CHASE AFTER ANODISING.
6. GENERAL TOLERANCES ISO 2768-mK. FLATNESS OF FACE A 0.2 OVER FULL LENGTH.

POCKET 9.6 DEEP FROM BACK FACE
(LEAVES 2.5 FRONT PLATE), SKIRT 2.0 WALL

FLOAT MOUNT v6 · SHELL (iPad mini (A17 Pro))

DESIGN: BRENDAN · FILE: shell_6061.step · github.com/brendan779/ipad-pro-wall-mount

MATERIAL
6061-T6 AL, 15 mm PLATE

FINISH
BEAD BLAST + ANODISE
