brendan779/ipad-pro-wall-mount/(commit log)

2026-10-19 Add Float v4.1 and Flush v5.1 iPad Pro 12.9 PoE wall mounts
    - Float v4.1: surface mount, machined 6061 shell + printed carrier, hook-and-lock bracket
    - Flush v5.1: in-wall mount, printed sleeve/deck/back plate, dog-ear clamp, magnetic 6061 trim, A3 cut-out template
    - CadQuery sources, STEP/STL for every part, overhang audit
    - Step-by-step build manuals (Markdown) with renders and schematics
    - Manual image tooling
    Claude-Session: https://claude.ai/code/session_01E2J2GFAHEvEZovjex5vPGv
    [assembly_flush_v5_1.step, assembly_hybrid_v4_1.step, back_plate_L.step, back_plate_L.stl, back_plate_R.step, back_plate_R.stl, carrier_BL.step, carrier_BL.stl]
2026-10-19 Add PDF build manuals for v4.1 and v5.1
    - Print-ready PDFs, one step per page (16:9), linked from every README
    - Tidy v5.1 general-data table; re-frame v4.1 step 1 render
    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
2026-10-19 Add fully printed versions of v4.1 and v5.1 with Bambu Studio 3MF projects
    - fully-printed/: printed face halves (centre split, dovetail keys, face-down, 0.8 mm chamfer)
    - v4.1 shell: self-tapping pilot holes, 1.6 mm skin over screw holes
    - v5.1 trim: printed magnet pockets and pin holes, 4 magnets + 1 pin per half
    - Bambu Studio 3MFs: named parts on plates, plate thumbnails, filament 2 for the face, per-part walls/infill
    - printed.py and make3mf.py to regenerate from the same parameters as the milled builds
    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
    [Float_Mount_v4.1_Printed.3mf, Float_Mount_v5.1_Flush_Printed.3mf, back_plate_L.stl, back_plate_R.stl, carrier_BL.stl, carrier_BR.stl, carrier_TL.stl, carrier_TR.stl]
2026-10-20 Add Float v4.2: CNC drawing for the shell, drill-safe threads, one-piece printed parts
    - machine/shell_6061_drawing.pdf: A3 drawing for JLCCNC (M3/M2.5-6H callouts, hole table, 4:1 boss section, finish, ISO 2768-mK)
    - Holes redesigned for a real 118-degree tap drill: 4.5 deep, 3.0 thread, 1.45/1.58 mm skin under the point (v4.1 left 0.45 mm)
    - Carrier screws now M3 x 5 / M2.5 x 5 (3.0 mm engagement)
    - One-piece carrier and one-piece printed shell alongside the split parts
    - fully-printed/float-v4.2-printed with 3MF; hybrid42.py, drawing42.py, printed42.py
    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
    [Float_Mount_v4.2_Printed.3mf, assembly_hybrid_v4_2.step, carrier_BL.step, carrier_BL.stl, carrier_BR.step, carrier_BR.stl, carrier_TL.step, carrier_TL.stl]
2026-10-20 Add Float v4.2 build manual (PDF + Markdown)
    - 39 pages: v4.2 screws (M3/M2.5 x 5), 4.5 mm drill / 3.0 mm thread, new JLCCNC ordering page with the drawing,
    printed-shell option (halves or one piece), one-piece carrier, updated parts list, files and print settings
    - READMEs point at the new manual
    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
2026-10-20 Add v6: Float + Flush for iPad Pro 12.9 (3rd gen), 13 and 11 (M5) and iPad mini (A17 Pro)
    - button relief pockets so the volume / top buttons are not pressed
    - 2 mm more USB-C loop room at each end (mounts 4 mm longer)
    - lateral stop cheeks on the Float catch rail
    - boss height tracks iPad thickness: 1.45 / 1.58 mm skin under every drill point
    - machined and fully printed builds in separate folders, one-piece parts,
    JLCCNC shell drawings, A3 cut-out templates, Bambu Studio 3MFs per model
    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
    [Float_Mount_v6_mini-a17-pro_Float_Printed.3mf, Float_Mount_v6_mini-a17-pro_Flush_Printed.3mf, Float_Mount_v6_pro-11-m5_Float_Printed.3mf, Float_Mount_v6_pro-11-m5_Flush_Printed.3mf, Float_Mount_v6_pro-12-9-gen3_Float_Printed.3mf, Float_Mount_v6_pro-12-9-gen3_Flush_Printed.3mf, Float_Mount_v6_pro-13-m5_Float_Printed.3mf, Float_Mount_v6_pro-13-m5_Flush_Printed.3mf]
2026-10-20 v6: build manuals (Float + Flush, all four iPads) and full hardware in the STEP assemblies
    - hardware6.py models every screw, heat-set insert, nut, magnet and dowel pin;
    all assemblies (machined and printed) now carry them, named by size and
    standard, with hardware.txt BOMs and clash / engagement checks
    - the check found a flush pin hole under a clamp post on the 11in and mini: fixed
    - M5 shell screws are ISO 7380 button heads (not DIN 7984)
    - carrier rear-camera keep-out clipped to the pocket (no wall undercut)
    - overhang audit of every printed part (overhang_audit.txt)
    - manuals: PDF + Markdown per mount, renders from the v6 CAD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
    [Float_Mount_v6_mini-a17-pro_Float_Printed.3mf, Float_Mount_v6_mini-a17-pro_Flush_Printed.3mf, Float_Mount_v6_pro-11-m5_Float_Printed.3mf, Float_Mount_v6_pro-11-m5_Flush_Printed.3mf, Float_Mount_v6_pro-12-9-gen3_Float_Printed.3mf, Float_Mount_v6_pro-12-9-gen3_Flush_Printed.3mf, Float_Mount_v6_pro-13-m5_Float_Printed.3mf, Float_Mount_v6_pro-13-m5_Flush_Printed.3mf]
2026-10-20 Reorganise: v6 at the root, v4.1 / v4.2 / v5.1 moved to previous-releases/
    - README.md is now the v6 page (both mounts, four iPads, manuals, layout)
    - per-iPad folders and manuals/ at the root; generators in src/
    - previous-releases/ holds float-v4.1, float-v4.2, flush-v5.1, fully-printed
    with their own README (superseded notice + the old overview)
    - render scripts and manual text updated for the new paths
    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
    [Float_Mount_v4.1_Printed.3mf, Float_Mount_v4.2_Printed.3mf, Float_Mount_v5.1_Flush_Printed.3mf, Float_Mount_v6_mini-a17-pro_Float_Printed.3mf, Float_Mount_v6_mini-a17-pro_Flush_Printed.3mf, Float_Mount_v6_pro-11-m5_Float_Printed.3mf, Float_Mount_v6_pro-11-m5_Flush_Printed.3mf, Float_Mount_v6_pro-12-9-gen3_Float_Printed.3mf]
2026-10-20 Fix Bambu Studio 3MFs opening without plates
    Bambu Studio treats a 3MF with no Metadata/project_settings.config as
    'not from Bambu Lab': it loads the geometry only, so the plates and the
    per-object wall/infill settings were dropped. Each project now carries a
    project config that names Bambu's own system presets (P1S 0.4, 0.20mm
    Standard, Bambu PETG Basic x2, Textured PEI) with no settings marked as
    different, so Bambu loads those presets unmodified. The version tag is
    lowered so older Bambu Studio releases don't warn about a newer file.
    All 8 v6 projects regenerated; the 3 previous-release 3MFs patched.
    Claude-Session: https://claude.a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
    [Float_Mount_v4.1_Printed.3mf, Float_Mount_v4.2_Printed.3mf, Float_Mount_v5.1_Flush_Printed.3mf, Float_Mount_v6_mini-a17-pro_Float_Printed.3mf, Float_Mount_v6_mini-a17-pro_Flush_Printed.3mf, Float_Mount_v6_pro-11-m5_Float_Printed.3mf, Float_Mount_v6_pro-11-m5_Flush_Printed.3mf, Float_Mount_v6_pro-12-9-gen3_Float_Printed.3mf]
2026-10-21 Float assemblies: catch rail as its own part
    The assembly STEPs added the wall bracket fused to the catch rail
    (br = br_plate + catch_rail), so the rail's lip and end stops showed as an
    unsupported cantilever on the bracket. They are two printed parts joined by
    four M3 screws into inserts; the assemblies now carry them separately, as
    the print STLs always did. All 8 Float assemblies regenerated, checks pass.
    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
    [assembly_float6.step, assembly_float6_printed.step]
